ArtemovSA/ILC_project/Info/Docs/Список команд устройства.docx

Список команд устройства (клиента)

Топик | Тип | Описание | Пример
/maser/devices | sub | Получить результат команды | {"devices": ["533906f8-65fd-4168-bad6-390e8c10ace3", "c90d2908-3bd2-11e8-b467-0ed5f89f718b"], "count": 2}
/master/show_devices | pub | Команда показать устройства
/master/new_device | pub | Добавить устройство в писок с уникальным ID | Id устройства
/master/stop_device | pub | Удалить устройство из списка | Id устройства
/variables/# | sub | Просто мониторить приходящие параметры от всех устройств
/variables/devID/# | pub/ sub | Отправить или получить параметры от устройства
/variables/devID/var1 | pub | Отправить или получить параметр var1
/attributes/# | pub/ sub | Отправить или получить атрибуты устройства
/attributes/devID/name | pub | Отправить имя устройства
