ArtemovSA/ILC_project/Info/Прошивка/Прошивка инструкция.docx

Подключение

Необходимо сделать переходник с разъёма j-Link на плату для 3-х проводников (X5 – GND, X3 – SWDIO, X2 – SWDCLK, X1 – RESET)

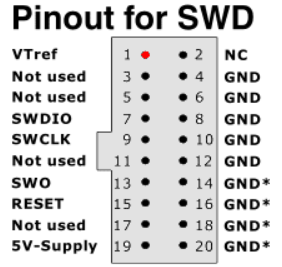
[picture p31: figure]

Рисунок -Разъем на J-LINK

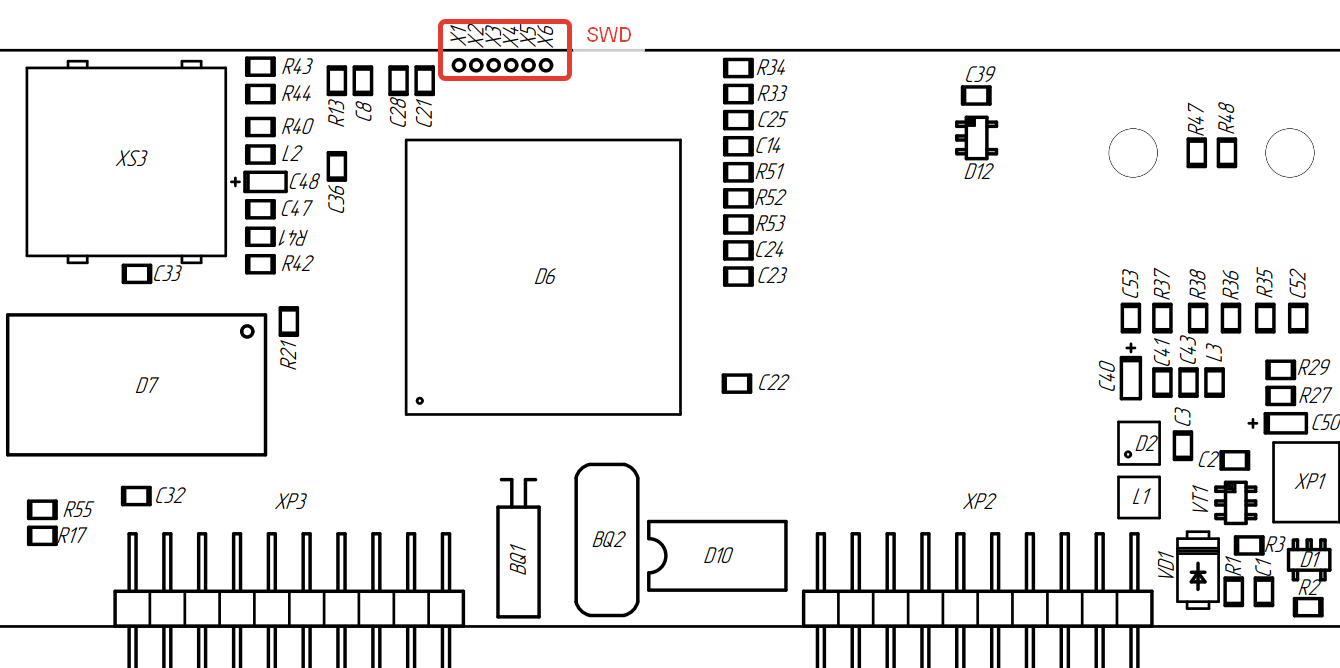
[picture p32: figure]
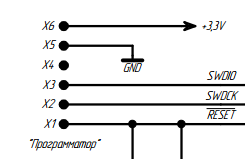
[picture p33: figure]

Рисунок – разъем на плате

Программирование

Открыть программу:

Создать новый проект

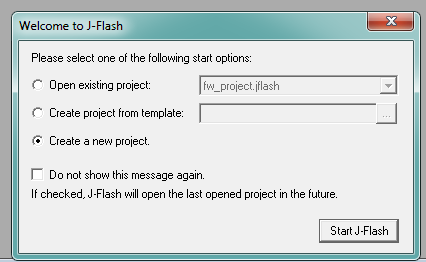
[picture p34: figure]

Options->Project settings (ALT+F7) ->Вкладка Target Interfase

Выбрать SWD

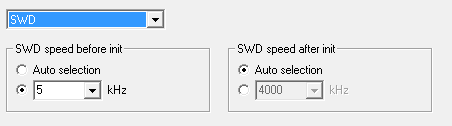
[picture p35: figure]

Вкладка CPU

Выбрать Device

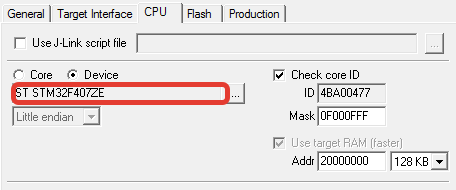
[picture p36: figure]

Из списка:

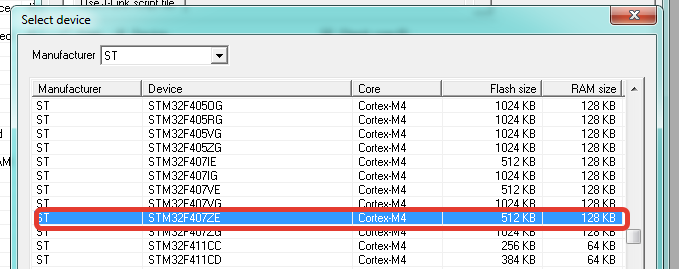
[picture p37: figure]

File->Open data file

Сначала открыть Bootloader.bin

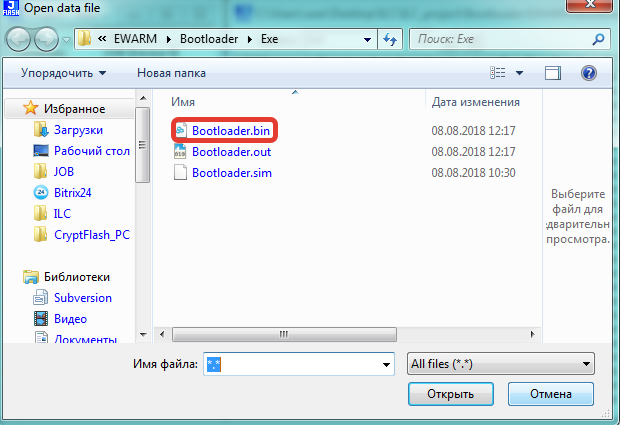
[picture p38: figure]

Указать начальный адрес в 0

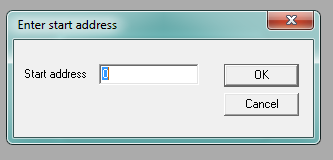
[picture p39: figure]
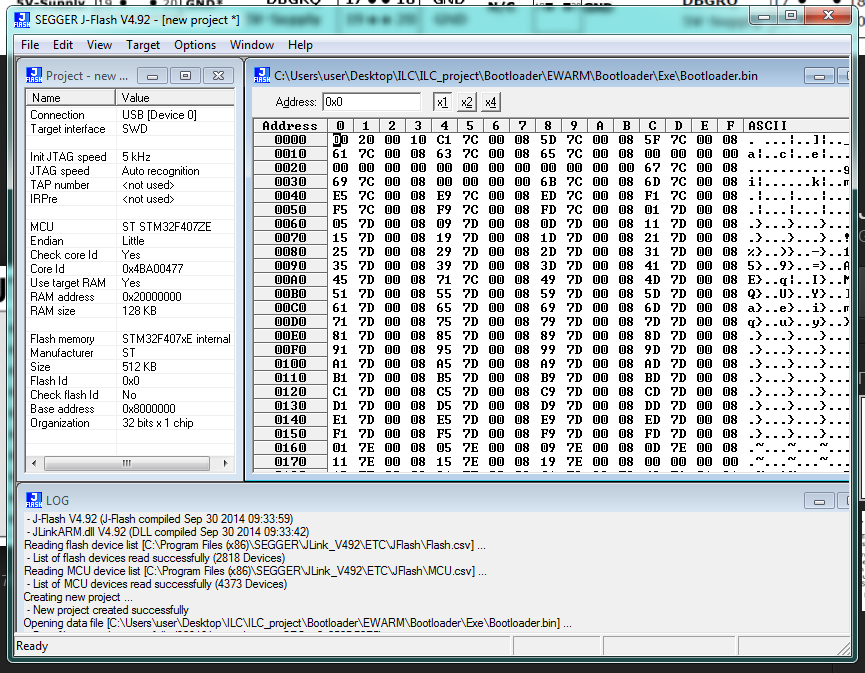
[picture p40: figure]

Убедиться в подаче питания и подключении платы.

Нажать Program & Verify (F6)

После прошивки бутлоадера. Открыть ILC.bin (основную программу)

Указать стартовый адрес со смещением 8000

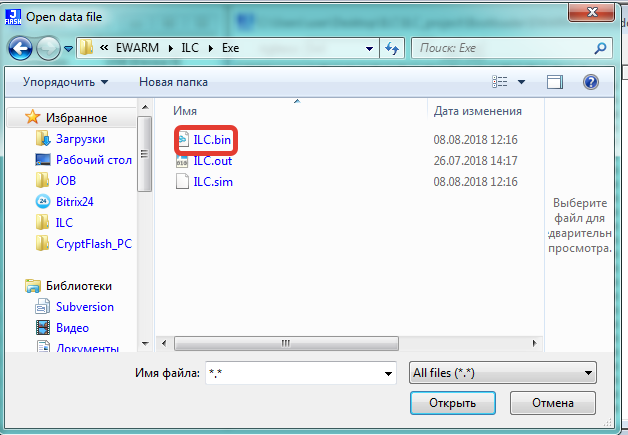
[picture p41: figure]
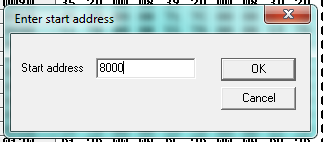
[picture p42: figure]

Нажать Program & Verify (F6)

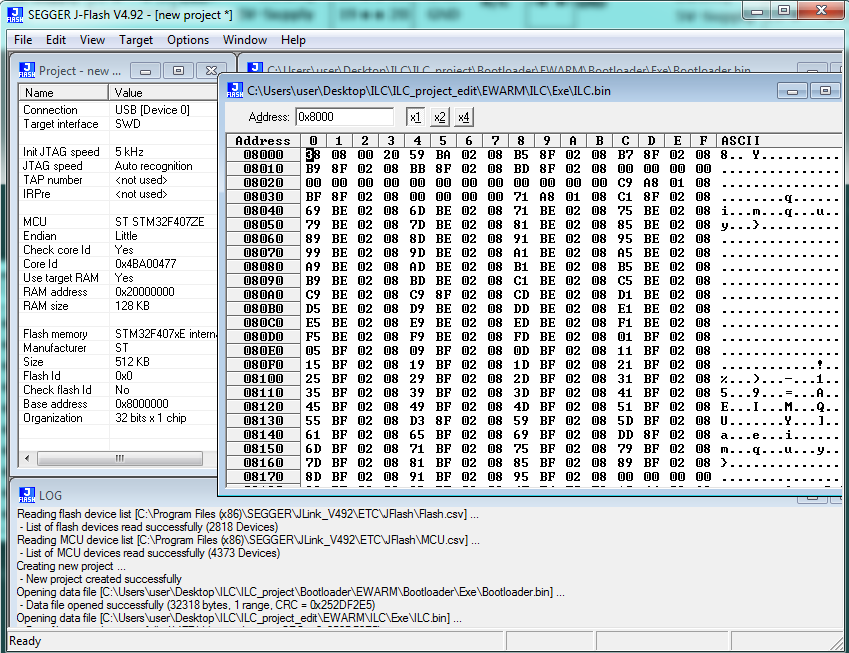
[picture p43: figure]
