ArtemovSA/ILC_project/Info/Второй подряд/структура.docx

1 Макет отладки силовой части счетчика

1.1 Макет потребителя (V9203 схема подключения потребителя с защитой)

1.2 Изменение режимов работы сети, их эмуляция

2 Отладочные средства контроллера (принципы отладки, интерфейс отладки)

2.1 Вывод отладочной информации (Логи, printf, swo)

2.2 Дополнительные отладочные средства

3 Отладочные средства интерфейса RS485/Modbus RTU

4. Отладка интерфейсов взаимодействия периферии
