ArtemovSA/ILC_project/Info/Схемы/GSM/IOT_GSM3G_v0_СБ_bot.pdf

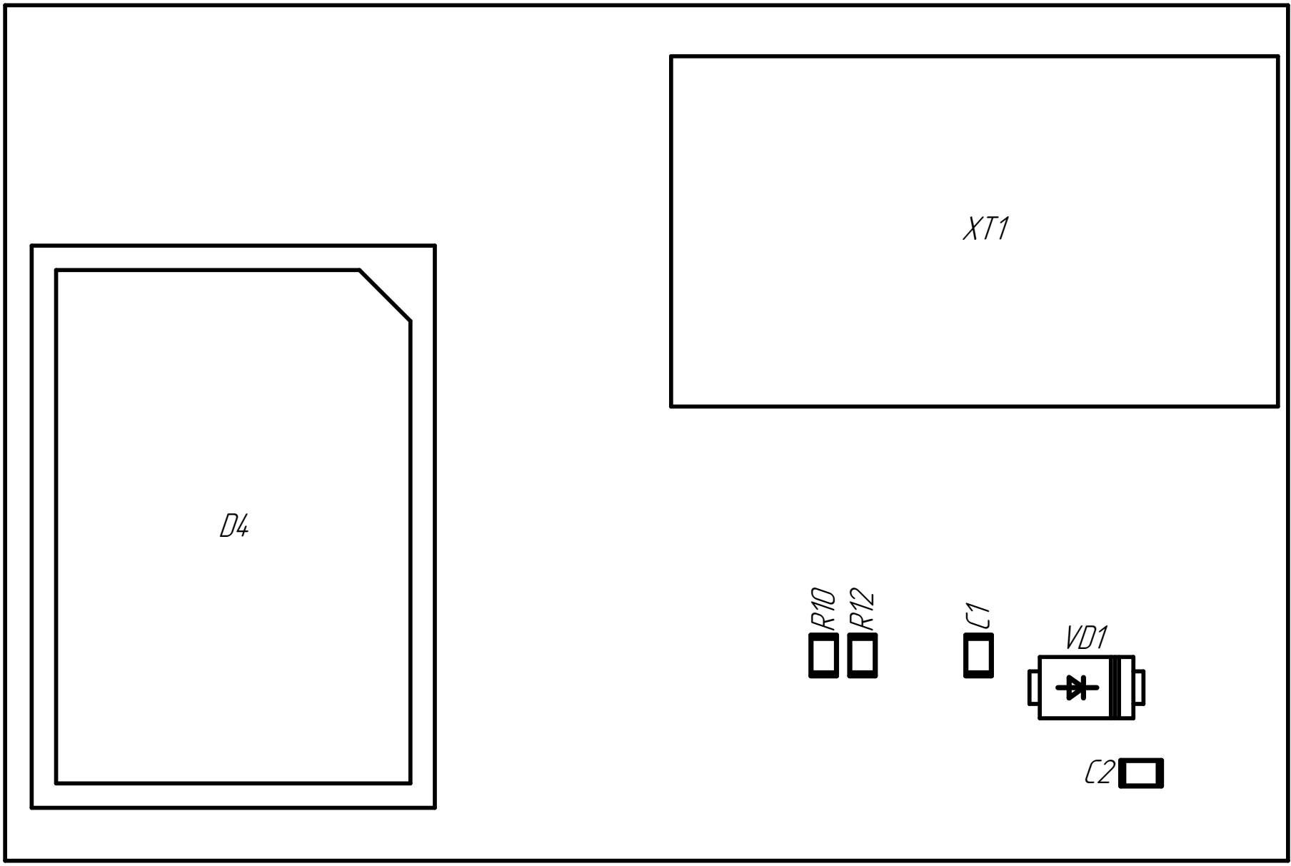
[picture p72: figure]
