ArtemovSA/ILC_project/Info/Второй подряд/Отчет 2.2/Без имени-1.png

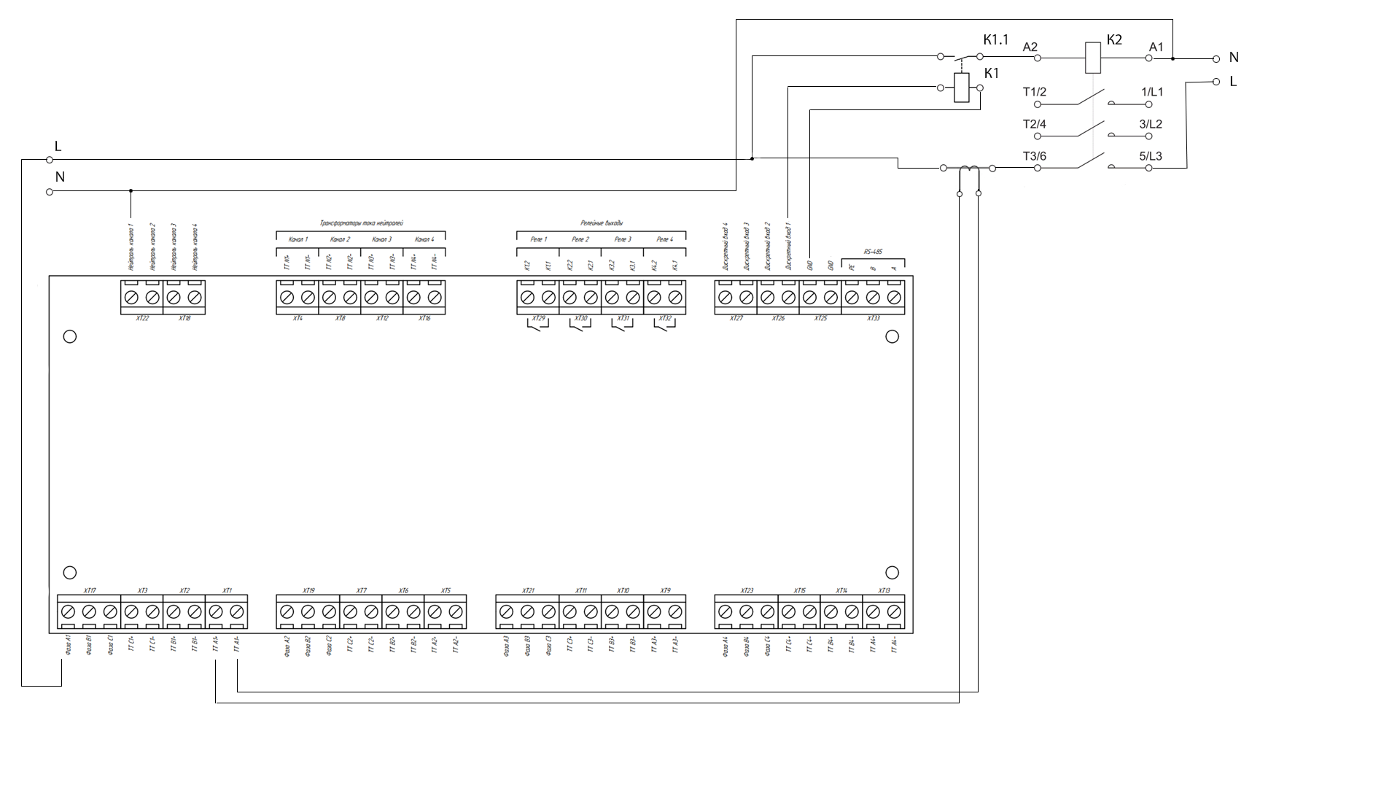
Info/Второй подряд/Отчет 2.2/Без имени-1.png
