ArtemovSA/ILC_project/Info/Отчет_3/Speed test.xlsx

T=1
 | Длина собщения
 | 8 | 16 | 32 | 64 | 128 | 256 | 512 | 1024 | 2048 | 4096 | 8192 | 16384 | 32768
Потери | 0.20% | 0.20% | 0.20% | 0.30% | 0.40% | 0.30% | 0.10% | 0.20% | 0.60% | 0.40% | 0.70% | 0.60% | 1.40%
Среднее время | 1 | 1 | 1 | 1 | 1 | 1 | 1 | 1 | 1 | 1 | 2 | 3 | 6
max время | 3 | 2 | 2 | 2 | 2 | 2 | 2 | 2 | 3 | 3 | 3 | 5 | 7
min время | 1 | 1 | 1 | 1 | 1 | 1 | 1 | 1 | 1 | 1 | 1 | 3 | 5
T=5
 | Длина собщения
 | 8 | 16 | 32 | 64 | 128 | 256 | 512 | 1024 | 2048 | 4096 | 8192 | 16384 | 32768
Потери | 0.10% | 0.10% | 0.10% | 0.10% | 0.20% | 0.30% | 0.30% | 0.30% | 0.20% | 0.20% | 0.60% | 0.50% | 1.20%
Среднее время | 1 | 1 | 1 | 1 | 1 | 1 | 1 | 1 | 1 | 2 | 2 | 3 | 6
max время | 1 | 1 | 1 | 1 | 2 | 2 | 2 | 2 | 2 | 3 | 3 | 5 | 9
min время | 1 | 1 | 1 | 1 | 1 | 1 | 1 | 1 | 1 | 1 | 1 | 3 | 5
T=10
 | Длина собщения
 | 8 | 16 | 32 | 64 | 128 | 256 | 512 | 1024 | 2048 | 4096 | 8192 | 16384 | 32768
Потери | 0.20% | 0.40% | 0.10% | 0.20% | 0.10% | 0.30% | 0.20% | 0.20% | 0.40% | 0.40% | 0.60% | 0.60% | 1.50%
Среднее время | 1 | 1 | 1 | 1 | 1 | 1 | 1 | 1 | 1 | 1 | 2 | 3 | 6
max время | 1 | 1 | 2 | 2 | 2 | 1 | 2 | 2 | 2 | 2 | 3 | 5 | 7
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
