ArtemovSA/ILC_project/Info/Схемы/CPU/IOT_CPU_v0_Э3_л3.pdf

# SDIO_D0 SDIO_D2 RD- TD+

## Ê ïëàòå ââîäà-âûâîäà

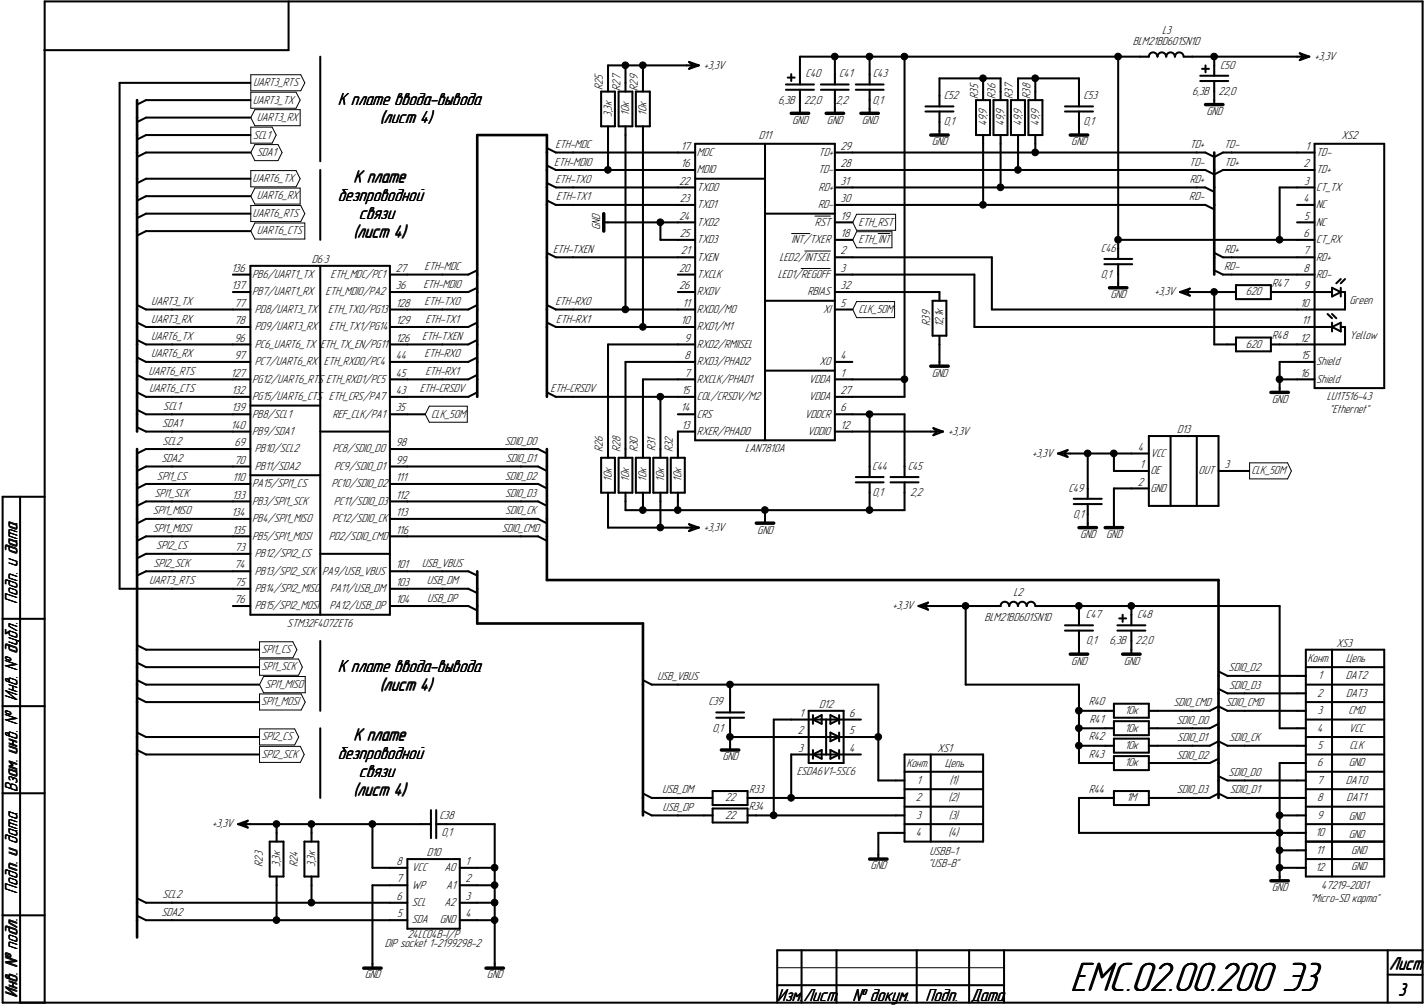
[picture p75: page 1]

27 ETH_MDC/PC1

3 LED1/REGOFF

Âçàì. èíâ. ¹ Èíâ. ¹ äóáë. Ïîäï. è äàòà

Êîíò. | Öåïü
1 | DAT2

Èíâ. ¹ ïîäë. Ïîäï. è äàòà Èçì.Ëèñò Èçì.Ëèñò ¹ äîêóì. Äàòà Ëèñò3

11 | GND
12 | GND

ÅÌÑ.02.00.200 Ý3

Ïîäï.
