ArtemovSA/ILC_project/Info/Схемы/CPU/IOT_CPU_v0_Э3_л4.pdf

## Ê ïëàòå ââîäà-âûâîäà

## Ê ïëàòå áåñïðîâîäíîé ñâÿçè

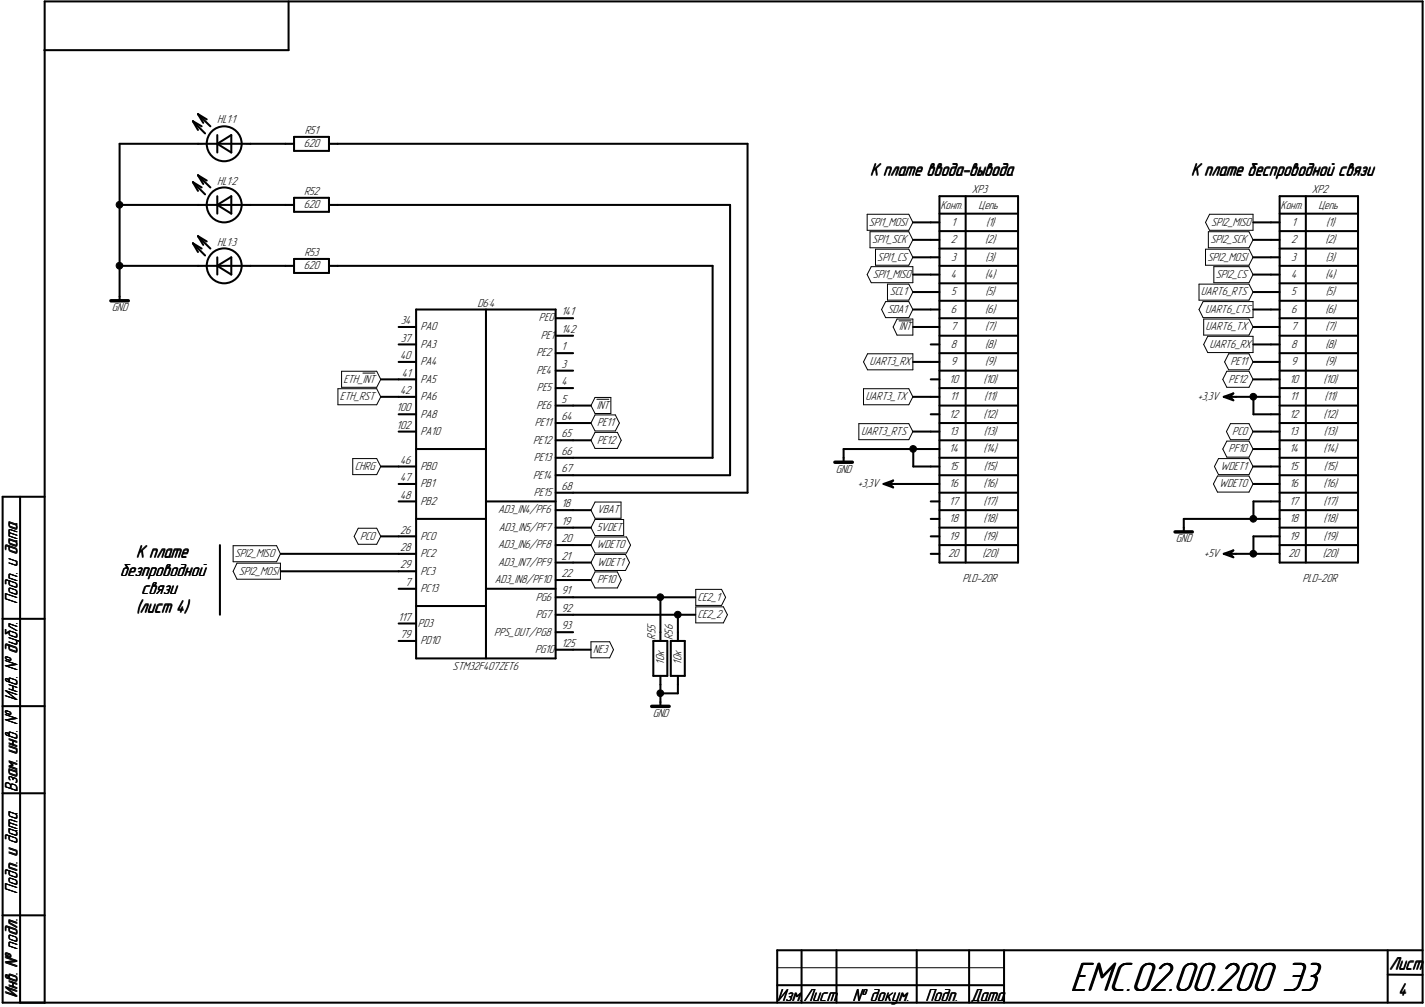
[picture p76: page 1]
GND; WDET1; 5VDET; VBAT; WDET0; INT; ETH_RST; UART3_TX; SCL1; SPI1_SCK; UART6_RX; UART6_RTS; SPI2_SCK; SPI2_MISO; SPI2_MOSI; CHRG; ETH_INT; UART3_RTS; SDA1; UART3_RX; SPI1_MOSI; SPI1_CS; SPI1_MISO; UART6_CTS; UART6_TX; SPI2_CS; Ê ïëàòå áåçïðîâîäíîé ñâÿçè; (ëèñò 4); 93 PPS_OUT/PG8; STM32F407ZET6; Êîíò.; Öåïü; PLD-20R

Âçàì. èíâ. ¹ Èíâ. ¹ äóáë. Ïîäï. è äàòà

Èíâ. ¹ ïîäë. Ïîäï. è äàòà Èçì.Ëèñò Èçì.Ëèñò ¹ äîêóì. Äàòà Ëèñò4

ÅÌÑ.02.00.200 Ý3

Ïîäï.
