ArtemovSA/ILC_project/Info/Схемы/CPU/IOT_CPU_v0_СБ_bot.pdf

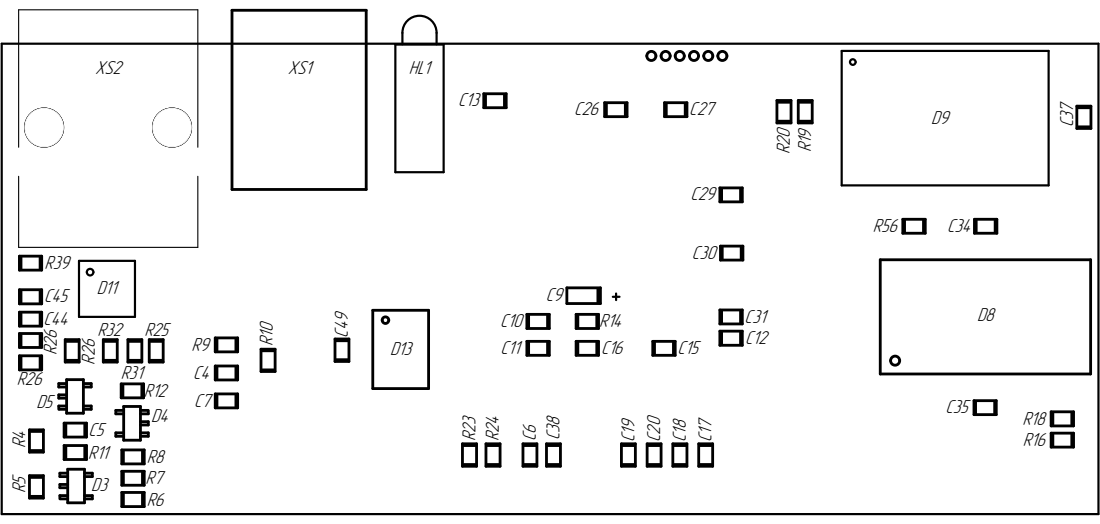
[picture p77: page 1]
