ArtemovSA/ILC_project/Info/Схемы/CPU/IOT_CPU_v0_СБ_top.pdf

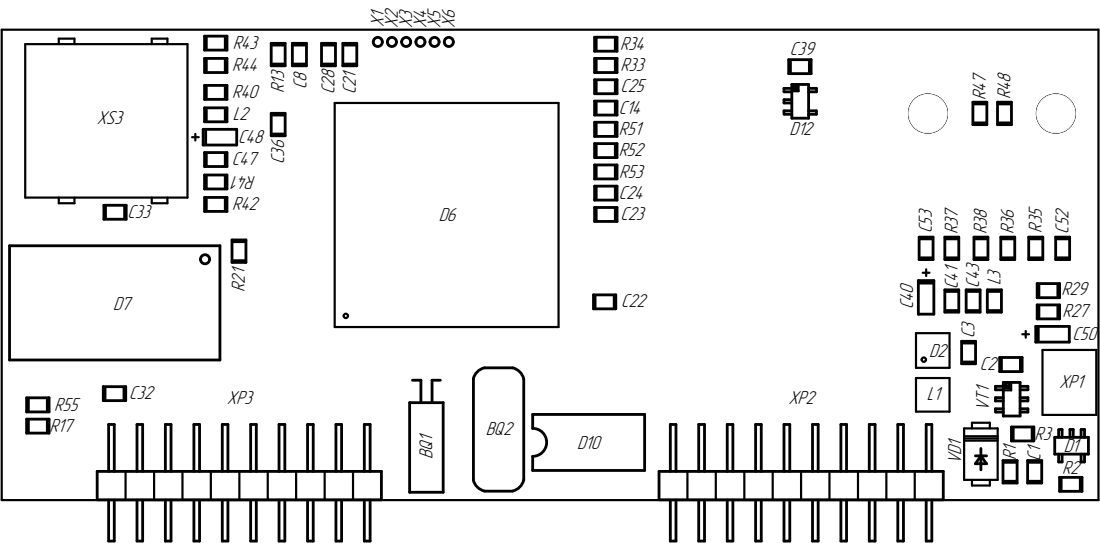
[picture p78: page 1]
