ArtemovSA/ILC_project/Info/Схемы/CPU/IOT_CPU_v0_Э3_л1.pdf

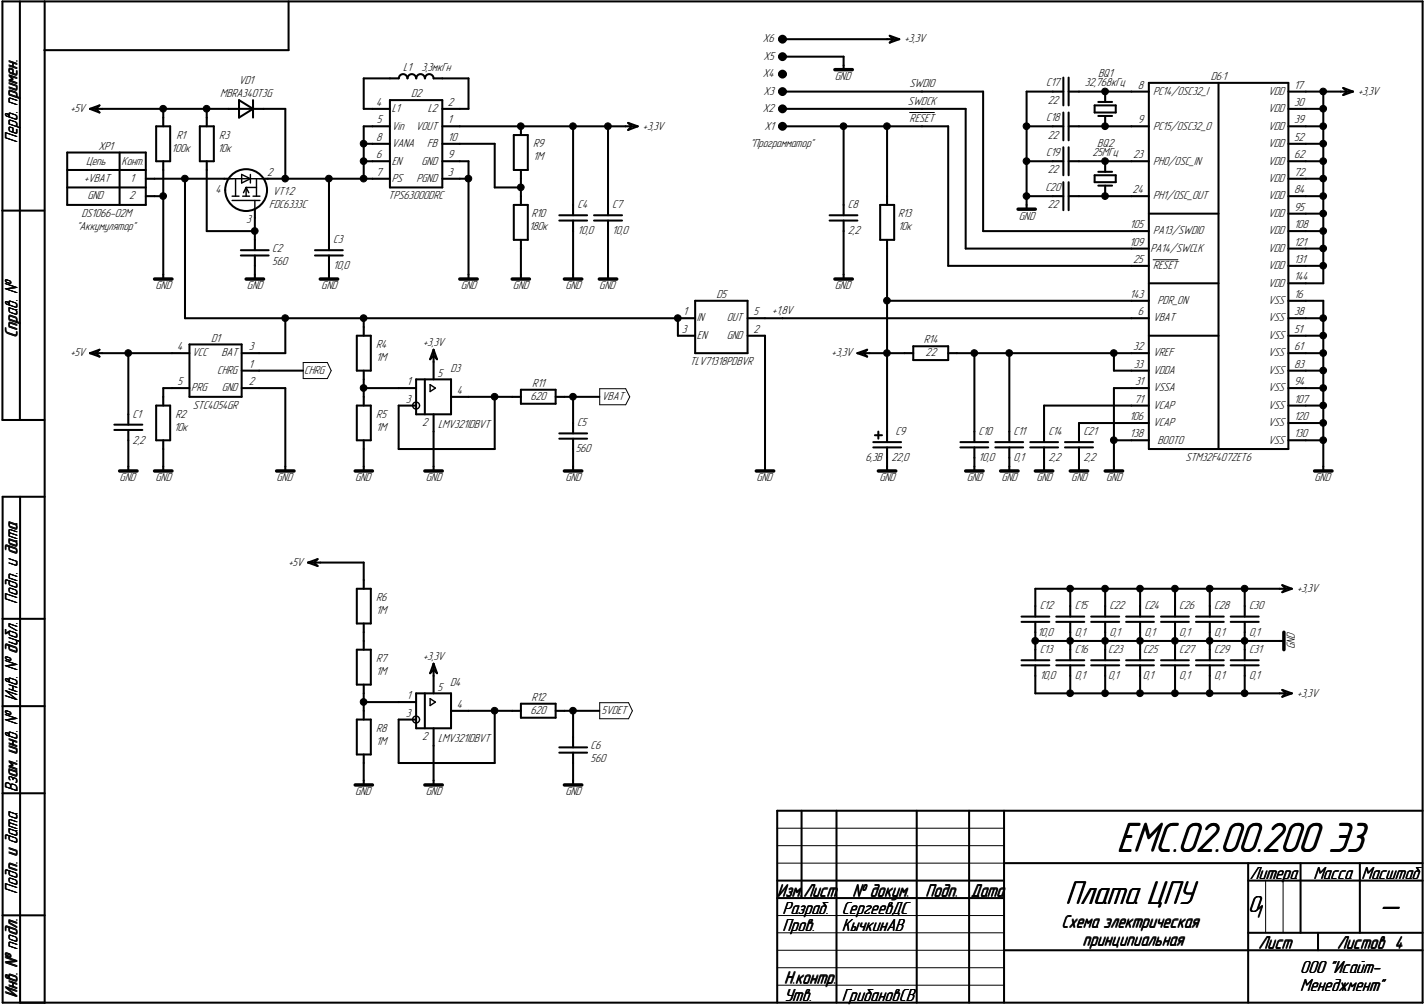
[picture p79: page 1]

Èíâ. ¹ ïîäë. Ïîäï. è äàòà Ñïðàâ. ¹ Ïåðâ. ïðèìåí. Óòâ. ÃðèáàíîâÑÂ Óòâ. ÃðèáàíîâÑÂ 4

Öåïü | Êîíò.
+VBAT | 1
GND | 2

Âçàì. èíâ. ¹ Èíâ. ¹ äóáë.

ÅÌÑ.02.00.200 Ý3

Èçì.Ëèñò Èçì.Ëèñò ¹ äîêóì. | | | Ïîäï. | Äàòà | | Î 1 | | | _
Ðàçðàá. | | ÑåðãååâÄÑ
Ïðîâ. | | Êû÷êèíÀÂ

Ïëàòà ÖÏÓ Ñõåìà ýëåêòðè÷åñêàÿ ïðèíöèïèàëüíàÿ | Ëèòåðà | Ìàññà | Ìàñøòàá Ì Ëèòåðà

Ëèñò | Ëèñòîâ

ÎÎÎ"Èñàéò-Ìåíåäæìåíò"
