ArtemovSA/ILC_project/Info/Схемы/CPU/IOT_CPU_v0_Э3_л2.pdf

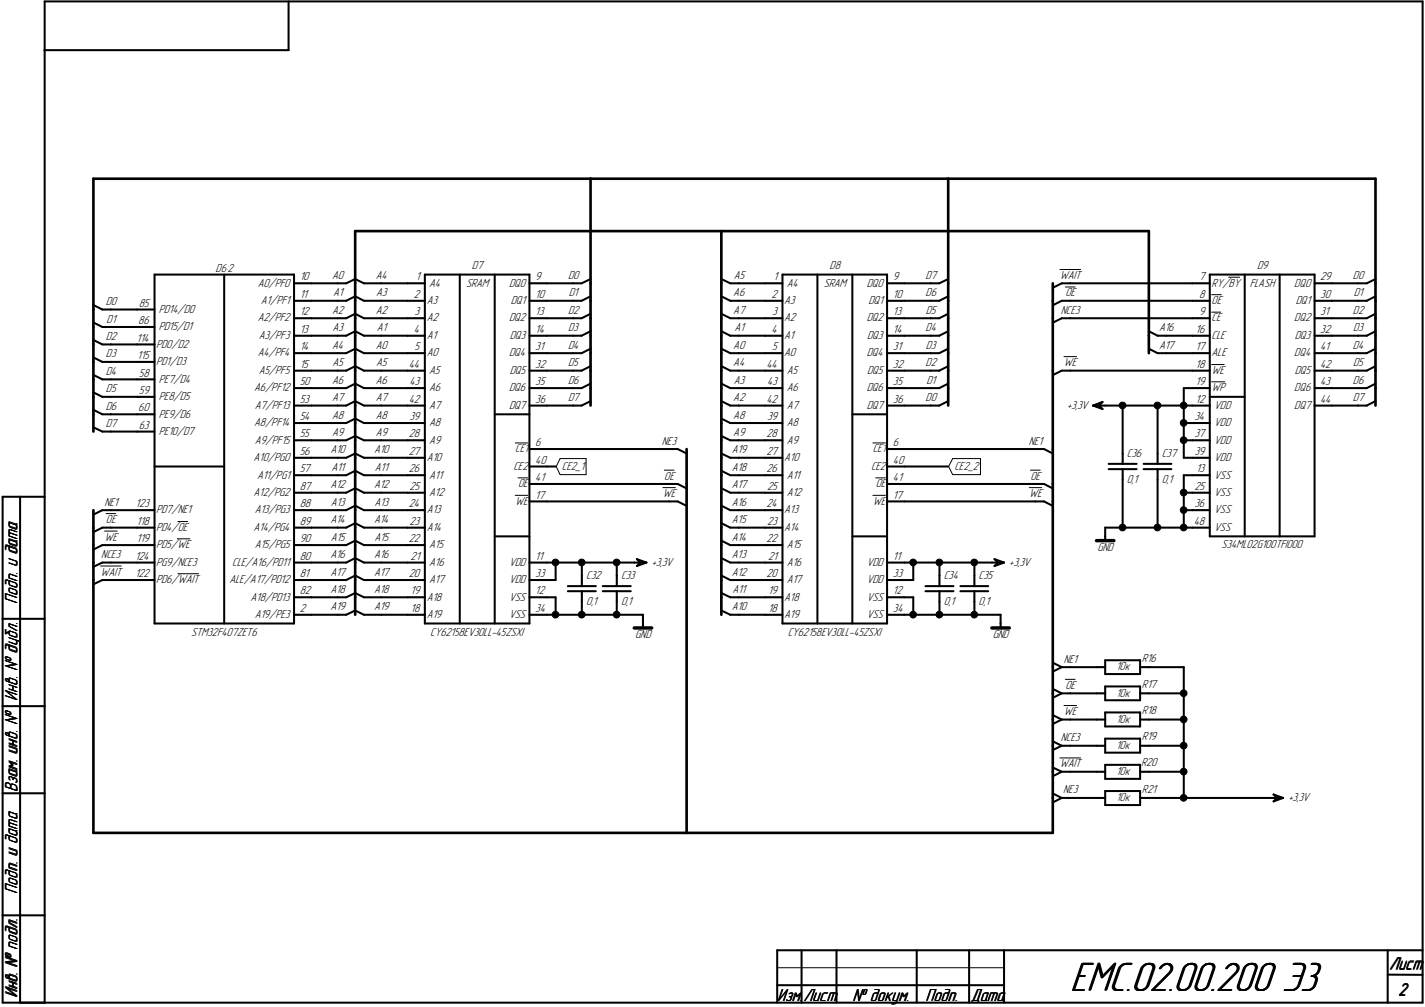
[picture p80: page 1]

Âçàì. èíâ. ¹ Èíâ. ¹ äóáë. Ïîäï. è äàòà

Èíâ. ¹ ïîäë. Ïîäï. è äàòà Èçì.Ëèñò Èçì.Ëèñò ¹ äîêóì. Äàòà Ëèñò2

ÅÌÑ.02.00.200 Ý3

Ïîäï.
