ArtemovSA/ILC_project/Info/Схемы/GSM/IOT_GSM3G_v0_СБ_top.pdf

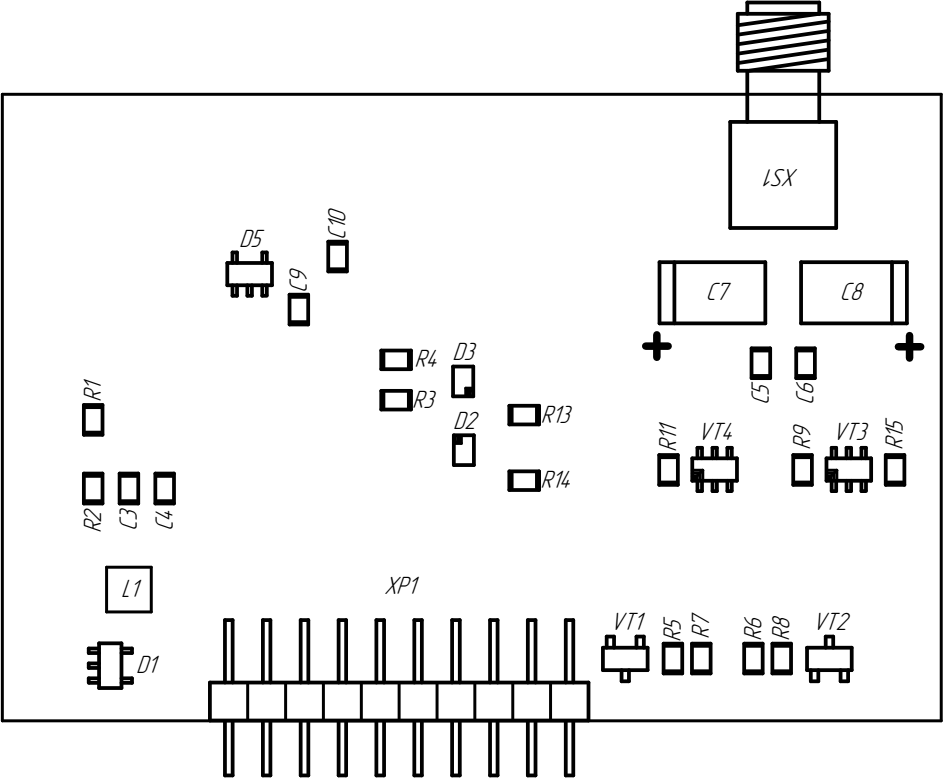
[picture p81: page 1]
