ArtemovSA/ILC_project/Info/Схемы/GSM/IOT_GSM3G_v0_схема.pdf

## Ê ïëàòå ÖÏÓ

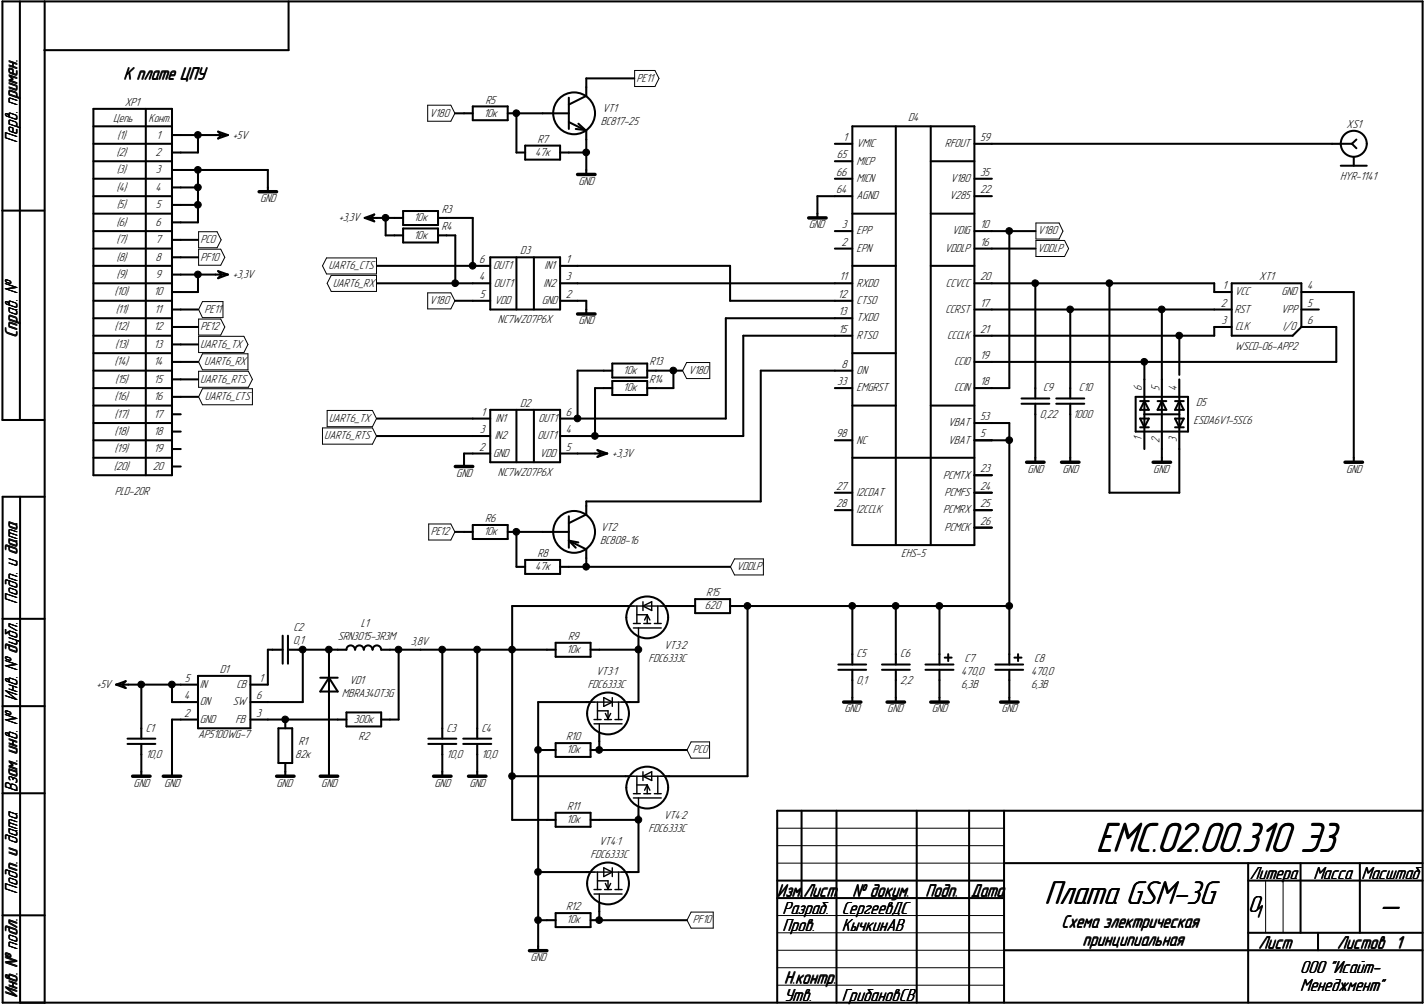
[picture p82: page 1]

Èíâ. ¹ ïîäë. Ïîäï. è äàòà Ñïðàâ. ¹ Ïåðâ. ïðèìåí. Óòâ. ÃðèáàíîâÑÂ Óòâ. ÃðèáàíîâÑÂ 1

Âçàì. èíâ. ¹ Èíâ. ¹ äóáë.

ÅÌÑ.02.00.310 Ý3

Èçì.Ëèñò Èçì.Ëèñò ¹ äîêóì. | | | Ïîäï. | Äàòà | | Î 1 | | | _
Ðàçðàá. | | ÑåðãååâÄÑ
Ïðîâ. | | Êû÷êèíÀÂ

Ïëàòà GSM-3G Ñõåìà ýëåêòðè÷åñêàÿ ïðèíöèïèàëüíàÿ | Ëèòåðà | Ìàññà | Ìàñøòàá Ì Ëèòåðà

Ëèñò | Ëèñòîâ

ÎÎÎ"Èñàéò-Ìåíåäæìåíò"
