ArtemovSA/ILC_project/Info/Схемы/IO/IOT_IO_v0_СБ_bot.pdf

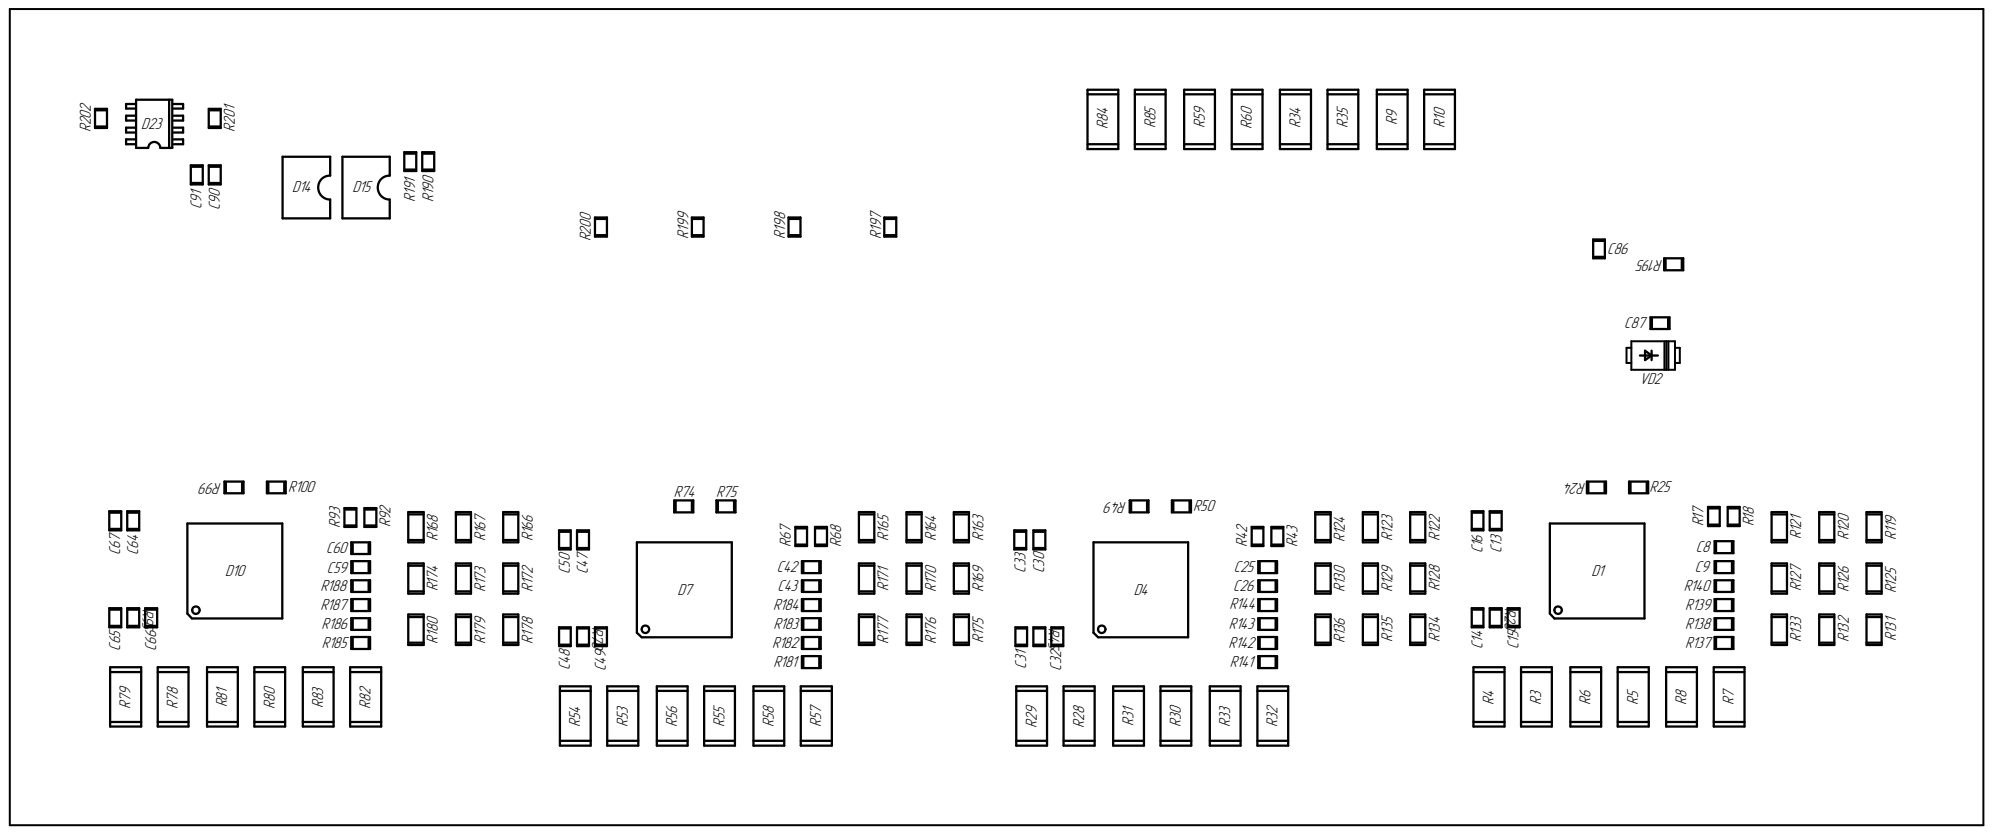
[picture p83: page 1]
