ArtemovSA/ILC_project/Info/Схемы/IO/IOT_IO_v0_СБ_top.pdf

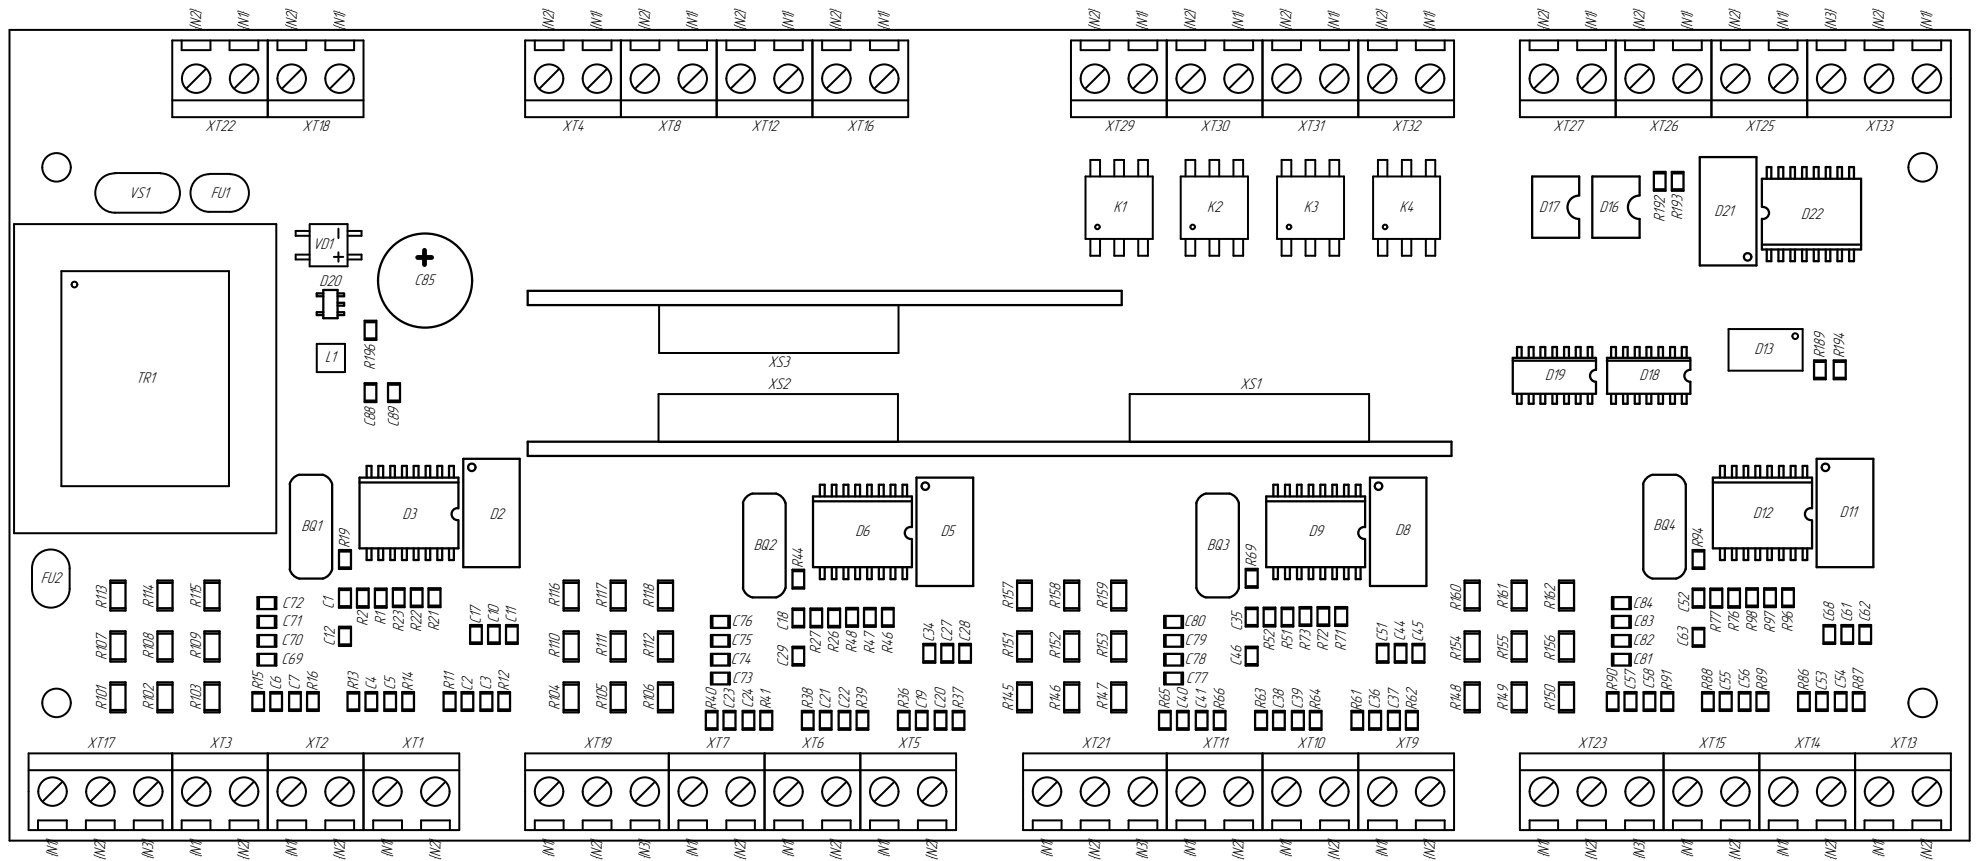
[picture p84: page 1]
