ArtemovSA/ILC_project/Info/Схемы/IO/IOT_IO_v0_Э3_л1.pdf

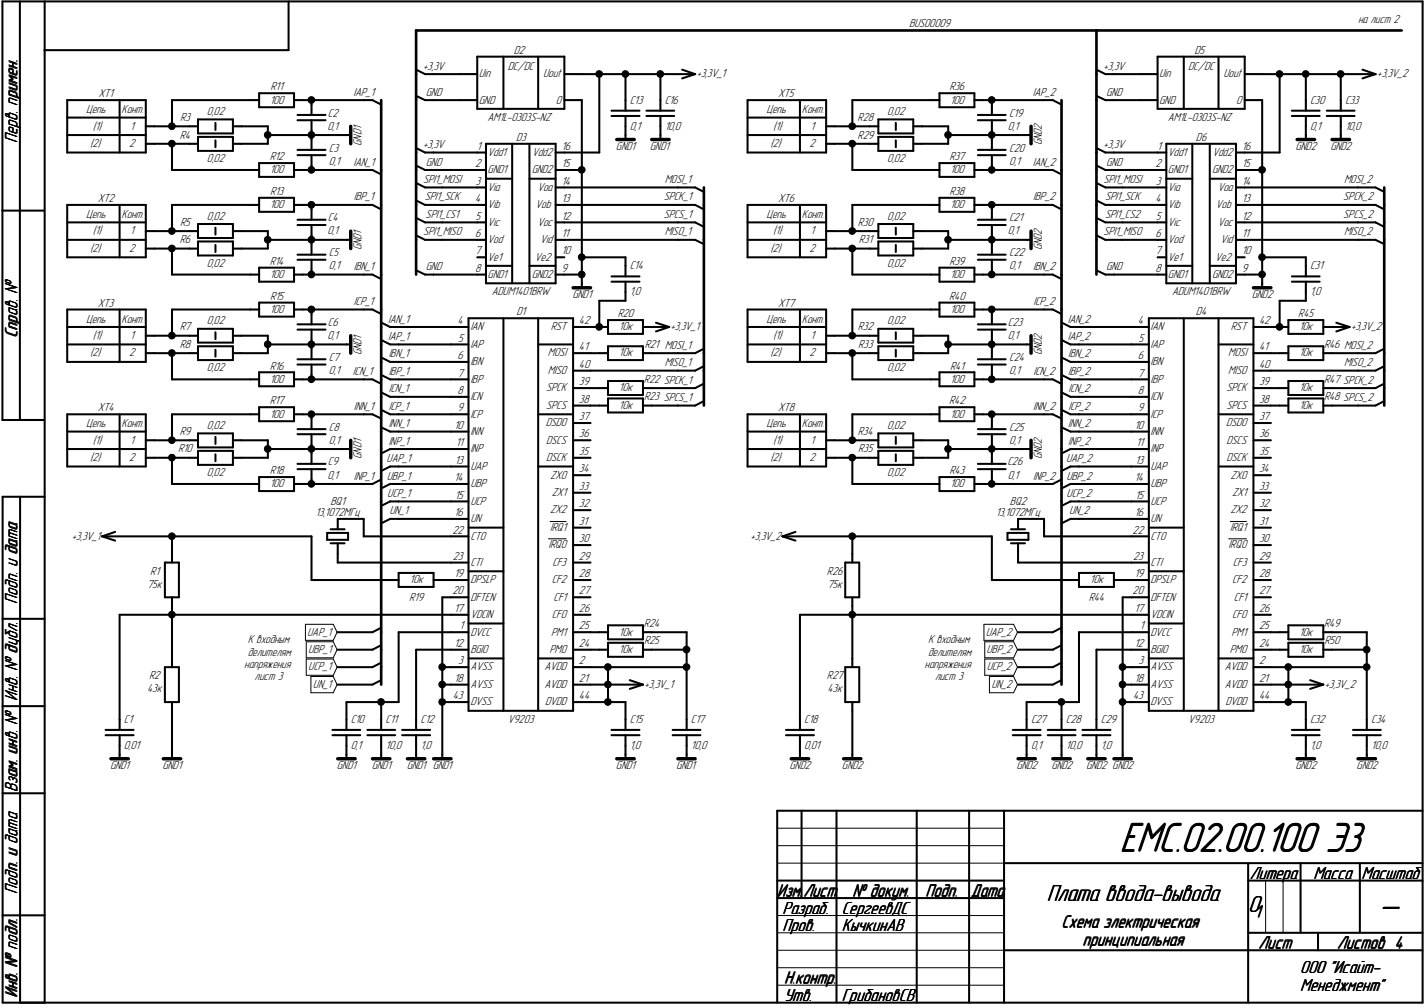
[picture p85: page 1]

Èíâ. ¹ ïîäë. Ïîäï. è äàòà Ñïðàâ. ¹ Ïåðâ. ïðèìåí. Óòâ. ÃðèáàíîâÑÂ Óòâ. ÃðèáàíîâÑÂ 4

Âçàì. èíâ. ¹ Èíâ. ¹ äóáë.

ÅÌÑ.02.00.100 Ý3

Èçì.Ëèñò Èçì.Ëèñò ¹ äîêóì. | | | Ïîäï. | Äàòà | | Î 1 | | | _
Ðàçðàá. | | ÑåðãååâÄÑ
Ïðîâ. | | Êû÷êèíÀÂ

Ïëàòà ââîäà-âûâîäà Ñõåìà ýëåêòðè÷åñêàÿ ïðèíöèïèàëüíàÿ | Ëèòåðà | Ìàññà | Ìàñøòàá Ì Ëèòåðà

Ëèñò | Ëèñòîâ

ÎÎÎ"Èñàéò-Ìåíåäæìåíò"
