ArtemovSA/ILC_project/Info/Схемы/IO/IOT_IO_v0_Э3_л4.pdf

| Ê ïëàòå ÖÏÓ BUS00009

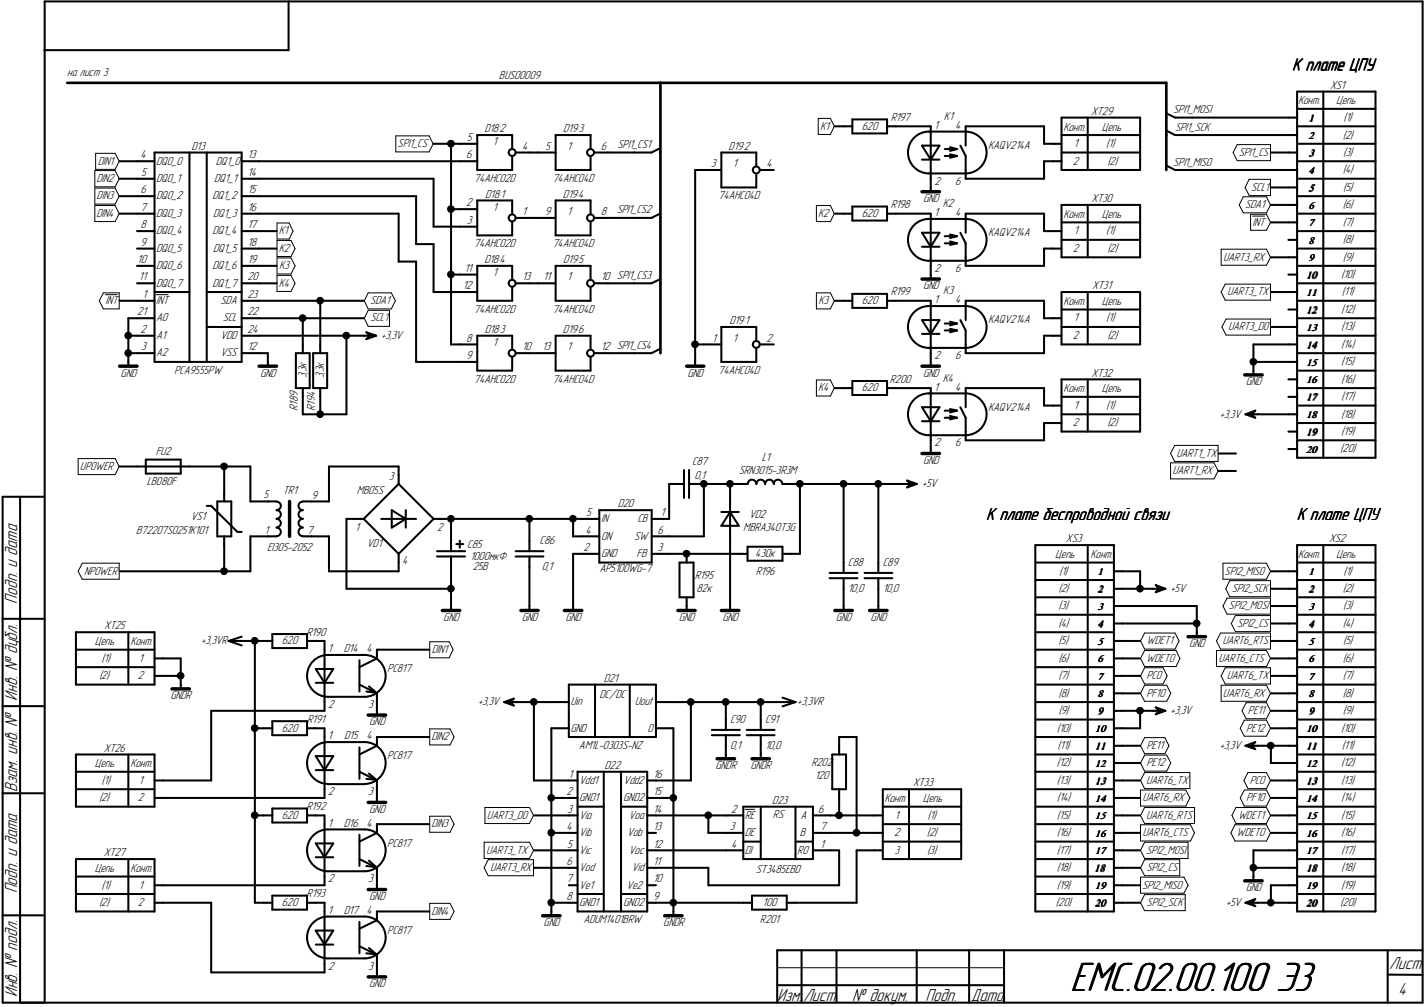
[picture p86: page 1]

Êîíò. | Öåïü

1 | {1}
2 | {2}

Âçàì. èíâ. ¹ Èíâ. ¹ äóáë. Ïîäï. è äàòà

Èíâ. ¹ ïîäë. Ïîäï. è äàòà Èçì.Ëèñò ¹ äîêóì. Äàòà Ëèñò

ÅÌÑ.02.00.100 Ý3

Ïîäï.
