ArtemovSA/ILC_project/Info/Схемы/IO/IOT_IO_v0_Э4.pdf

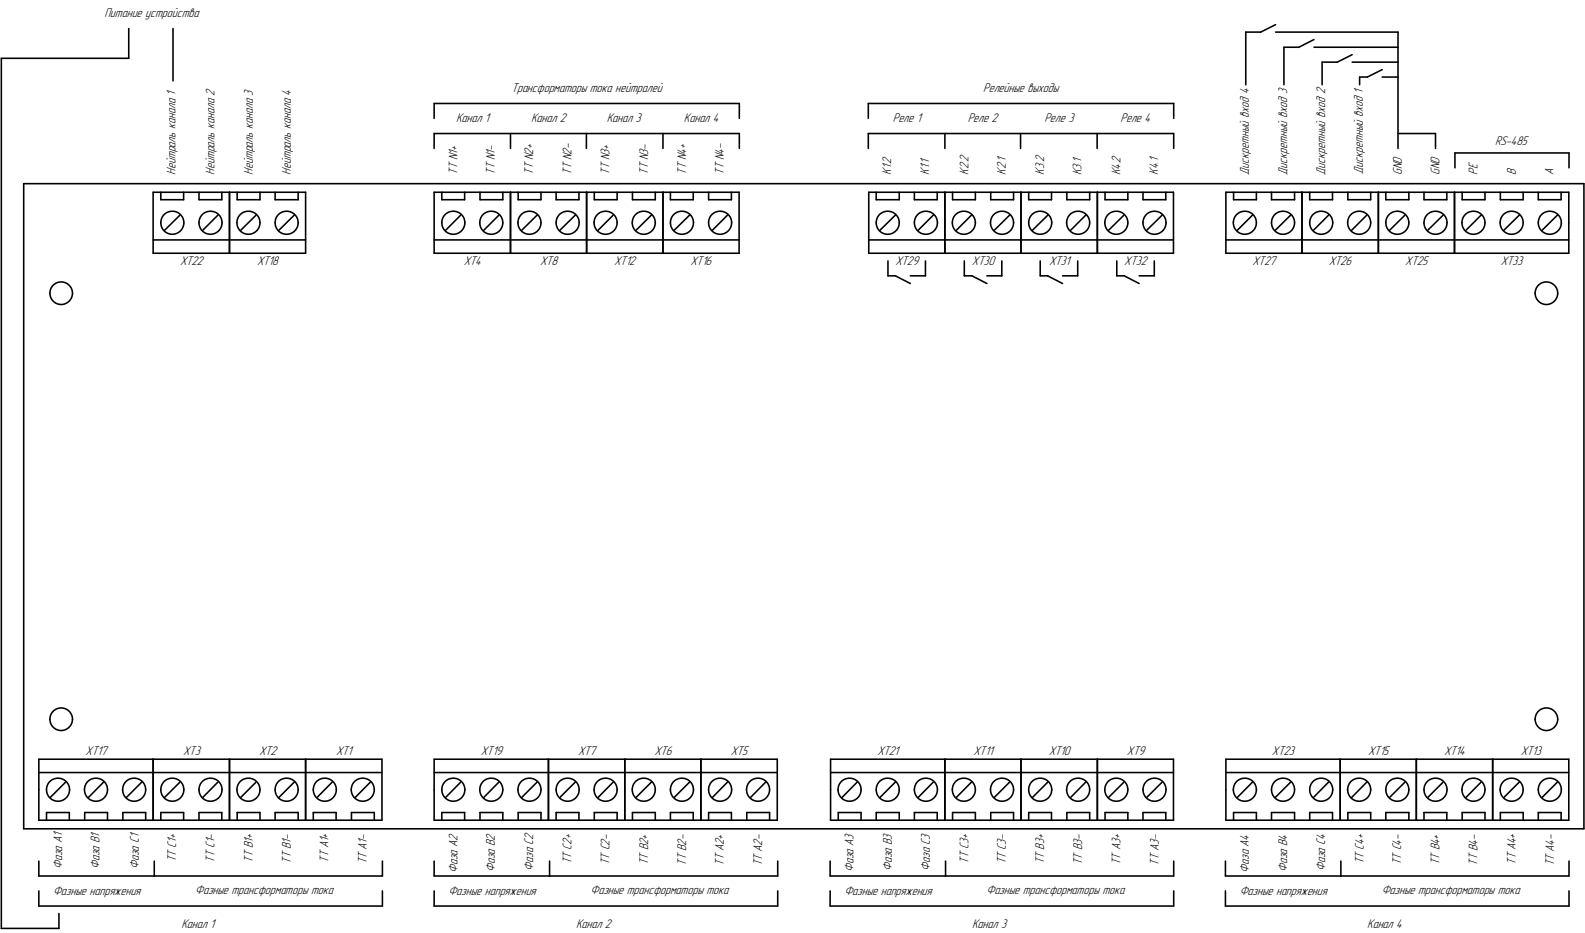
[picture p87: page 1]
Êàíàë 3; Ðåëå 1; Ðåëå 2; Ðåëå 4; Ôàçíûå íàïðÿæåíèÿ; Êàíàë 2; Ðåëå 3; Ðåëåéíûå âûõîäû; Ôàçíûå òðàíñôîðìàòîðû òîêà; Êàíàë 1; Ïèòàíèå óñòðîéñòâà; Êàíàë 4; GND; Ôàçà À1; Ôàçà Â1; Ôàçà Ñ1; Íåéòðàëü êàíàëà 3; Íåéòðàëü êàíàëà 4; Ôàçà À4; Ôàçà Â4; Ôàçà Ñ4; Äèñêðåòíûé âõîä 4; Äèñêðåòíûé âõîä 3; Ôàçà À2; Ôàçà Â2; Ôàçà Ñ2; Ôàçà À3; Ôàçà Â3; Ôàçà Ñ3; Íåéòðàëü êàíàëà 1; Íåéòðàëü êàíàëà 2; Äèñêðåòíûé âõîä 2; Äèñêðåòíûé âõîä 1

Òðàíñôîðìàòîðû òîêà íåéòðàëåé

Ôàçíûå òðàíñôîðìàòîðû òîêà
