ArtemovSA/ILC_project/(list of files, drawings)

Other design files:
Info/Схемы/CPU/Imported IOT_CPU_v0.PrjPcb/First_Sheet.SCHDOC
Info/Схемы/CPU/Imported IOT_CPU_v0.PrjPcb/IOT_CPU_v0.PcbDoc
Info/Схемы/CPU/Imported IOT_CPU_v0.PrjPcb/IOT_CPU_v0.PrjPcb
Info/Схемы/CPU/Imported IOT_CPU_v0.PrjPcb/Sheet1.SCHDOC
Info/Схемы/CPU/Imported IOT_CPU_v0.PrjPcb/Sheet2.SCHDOC
Info/Схемы/CPU/Imported IOT_CPU_v0.PrjPcb/Sheet3.SCHDOC
Info/Схемы/CPU/Imported IOT_CPU_v0.PrjPcb/Sheet4.SCHDOC
Info/Схемы/CPU/IOT_CPU_v0.pcb
Info/Схемы/GSM/IOT_GSM3G_v0.pcb
Info/Схемы/IO/Imported IOT_IO_v0.PrjPcb/First_Sheet.SCHDOC
Info/Схемы/IO/Imported IOT_IO_v0.PrjPcb/IOT_IO_v0.PcbDoc
Info/Схемы/IO/Imported IOT_IO_v0.PrjPcb/IOT_IO_v0.PrjPcb
Info/Схемы/IO/Imported IOT_IO_v0.PrjPcb/Sheet1.SCHDOC
Info/Схемы/IO/Imported IOT_IO_v0.PrjPcb/Sheet2.SCHDOC
Info/Схемы/IO/Imported IOT_IO_v0.PrjPcb/Sheet3.SCHDOC
Info/Схемы/IO/Imported IOT_IO_v0.PrjPcb/Sheet4.SCHDOC
Info/Схемы/IO/IOT_IO_v0.pcb
