ArtemovSA/ILC_project/Info/Схемы/V9203_Devkit-master/V9203_Devkit.kicad_pcb

## KiCad design Info/Схемы/V9203_Devkit-master/V9203_Devkit.kicad_pcb (2018-06-10)

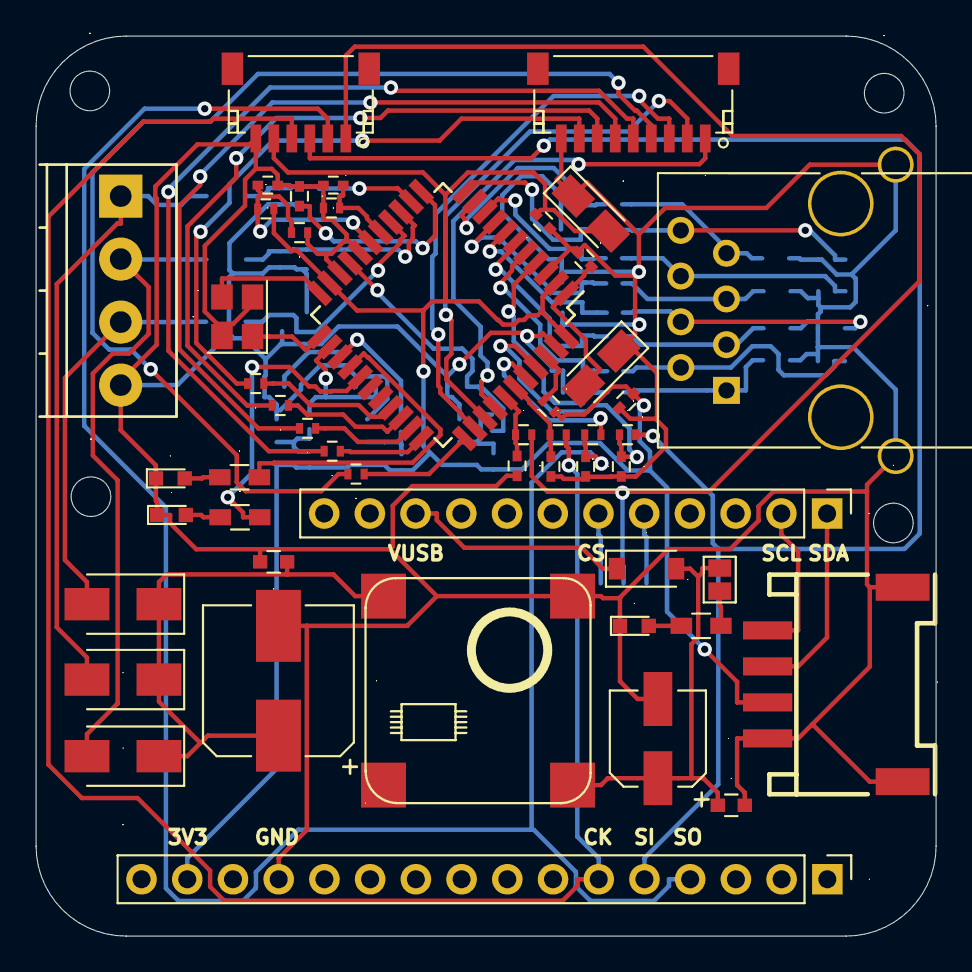
[picture p88: board V9203_Devkit.kicad_pcb from above]

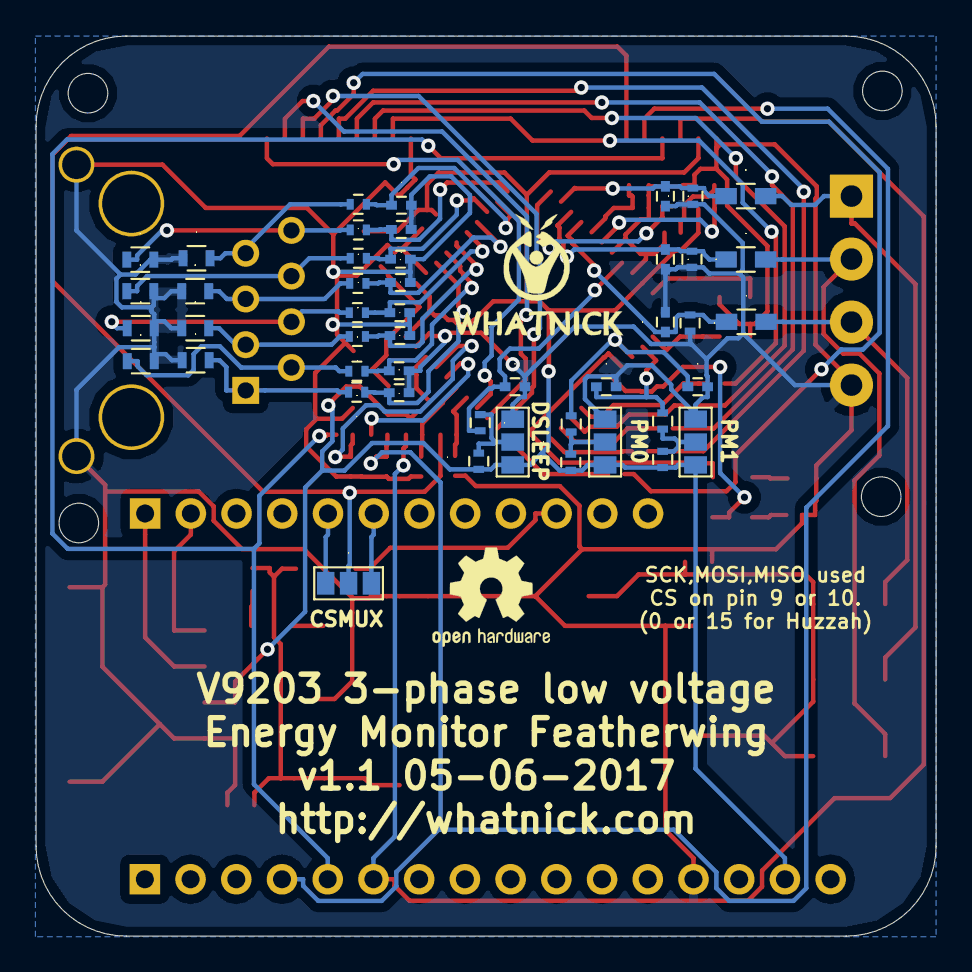
[picture p89: board V9203_Devkit.kicad_pcb from below]

Board: 2 copper layers, 50.0 x 50.0 mm, 102 parts (48 on the bottom side), 71 nets.

Parts:
C1: 220u/50V; CP_Elec_8x10
C2: 100u/16V; CP_Elec_5x5.8
C3: 1u/16V; C_0603
C4: 1u/50V; C_0603
C5, C6, C7, C8, C9, C10, C11, C12, C15, C17, C18, C19, C21, C28, C29, C30: 100n; C_0402
C13, C14: 10u; CP_Tantalum_Case-A_EIA-3216-18_Reflow
C16, C20, C27: 1u; C_0402
C22: 10n; C_0402
C23, C24, C25, C26: 1n; C_0402
D1, D2, D3: D_Schottky; D_SMA_Standard
D4, D6, D7: LED; LED_0603
D5: D_Schottky; D_SOD-123
J1: RJ45; RJ45_8
J2: CONN_01X16; Socket_Strip_Straight_1x16_Pitch2.54mm
J3: CONN_01X12; Socket_Strip_Straight_1x12_Pitch2.54mm
J4: Screw_Terminal_1x04; TerminalBlock_Pheonix_PT-3.5mm_4pol
J5: GROVE-CONNECTOR-SMD-90D(4+2P-2.0); HW4-SMD-2.0-90D
J6: JST9; JST_SH_SM09B-SRSS-TB_09x1.00mm_Angled
J7, J8, J10, J11: GS3
J9: JST6; JST_SH_SM06B-SRSS-TB_06x1.00mm_Angled
JP1: Jumper_NC_Small; GS2
LOGO1: OPEN_HARDWARE_1; OSHW-Logo2_7.3x6mm_SilkScreen
LOGO2: LOGO; Whatnick_logo
MK1, MK2, MK3, MK4: Mounting_Hole; MountingHole_2.2mm_M2
R1, R27, R28: 1K; R_0603_HandSoldering
R2, R3, R4, R5, R6, R7, R8, R9, R13, R14, R15, R16: 100R; R_0402
R10, R11, R12: 100K; R_0603_HandSoldering
R17, R18, R19, R20, R21, R22, R23, R24: 2.4R/10ppm; R_0603
R25: 75K; R_0402
R26: 43K; R_0402
R29, R30, R31, R32: 1K; R_0402
R33: 10K; R_0402
R34, R35, R36, R37, R38, R39, R40, R41: 20K; R_0402
R42, R43, R44: 100K; R_0402
U1: V9203; TQFP-44_10x10mm_Pitch0.8mm
U2: ROF-78E; SMD-4
Y1: Crystal_GND24; Crystal_SMD_Abracon_ABM8G-4pin_3.2x2.5mm

Connections:
+3V3: C13.2, C16.1, C27.2, J2.15, J5.3, J7.1, J8.1, J9.5, J10.1, R25.2, R33.2, R42.1, R43.1, R44.1, U1.2, U1.21, U1.44
/V9203/DS: C30.1, R41.2, U1.19
/V9203/IAN: C5.1, R2.1, U1.4
/V9203/IAN_IN: J1.1, R2.2, R17.2
/V9203/IAP: C6.2, R3.1, U1.5
/V9203/IAP_IN: J1.2, R3.2, R18.1
/V9203/IBN: C9.1, R6.1, U1.6
/V9203/IBN_IN: J1.3, R6.2, R21.2
/V9203/IBP: C10.2, R7.1, U1.7
/V9203/IBP_IN: J1.4, R7.2, R22.1
/V9203/ICN: C7.1, R4.1, U1.8
/V9203/ICN_IN: J1.5, R4.2, R19.2
/V9203/ICP: C8.2, R5.1, U1.9
/V9203/ICP_IN: J1.6, R5.2, R20.1
/V9203/INN: C11.1, R8.1, U1.10
/V9203/INN_IN: J1.7, R8.2, R23.2
/V9203/INP: C12.2, R9.1, U1.11
/V9203/INP_IN: J1.8, R9.2, R24.1
/V9203/UAP: C17.1, R10.1, R13.2, U1.13
/V9203/UBP: C18.1, R11.1, R14.1, U1.14
/V9203/UCP: C19.1, R12.1, R15.1, U1.15
/V9203/V_CLK: C25.1, R32.1, U1.39
/V9203/V_CS: C24.1, R31.1, U1.38
/V9203/V_MISO: R30.1, U1.40
/V9203/V_MOSI: C26.1, R29.1, U1.41
CS: J9.1, J11.2, R31.2
GND: C1.2, C2.2, C3.2, C4.2, C5.2, C6.1, C7.2, C8.1, C9.2, C10.1, C11.2, C12.1, C13.1, C14.1, C15.1, C16.2, C17.2, C18.2, C19.2, C20.1, C21.2, C22.1, C23.2, C24.2, C25.2, C26.2, C27.1, C28.2, C29.2, C30.2, D4.1, D6.1, D7.1, J1.9, J2.13, J4.4, J5.4, J5.SS1, J5.SS2, J6.9, J7.3, J8.3, J9.6, J10.3, R13.1, R14.2, R15.2, R16.2, R17.1, R18.2, R19.1, R20.2, R21.1, R22.2, R23.1, R24.2, R26.1, U1.3, U1.18, U1.20, U1.43, U2.2, Y1.2, Y1.4
MISO: C23.1, J2.4, J9.2, R30.2
MOSI: J2.5, J9.3, R29.2
unnamed: C1.1, C4.1, D1.1, D2.1, D3.1, U2.1
unnamed: C2.1, C3.1, D5.2, JP1.2, U2.3
unnamed: C14.2, C15.2, U1.1
unnamed: C20.2, U1.12
unnamed: C21.1, R16.1, U1.16
unnamed: C22.2, R25.1, R26.2, U1.17
unnamed: D4.2, R1.2
unnamed: D6.2, R27.1
unnamed: D7.2, R28.1
unnamed: J6.1, U1.37
unnamed: J6.2, U1.36
unnamed: J6.3, U1.35
unnamed: J6.4, R34.2
unnamed: J6.5, R37.2
unnamed: J6.6, R38.2
unnamed: J6.7, R35.2
unnamed: J6.8, R36.2
unnamed: J7.2, R39.1, R42.2
unnamed: J8.2, R40.1, R44.2
unnamed: J10.2, R41.1, R43.2
unnamed: J3.6, J11.1
unnamed: J3.5, J11.3
unnamed: JP1.1, R1.1
unnamed: R27.2, U1.27
unnamed: R28.2, U1.26
unnamed: R33.1, U1.42
unnamed: R34.1, U1.34
unnamed: R35.1, U1.31
unnamed: R36.1, U1.30
unnamed: R37.1, U1.33
unnamed: R38.1, U1.32
unnamed: U1.22, Y1.3
unnamed: U1.23, Y1.1
PM0: C29.1, R40.2, U1.24
PM1: C28.1, R39.2, U1.25
SCK: J2.6, J9.4, R32.2
SCL: J3.2, J5.1
SDA: J3.1, J5.2
UA: D2.2, J4.1, R10.2
UB: D1.2, J4.2, R11.2
UC: D3.2, J4.3, R12.2
USB: D5.1, J3.10
