ArtemovSA/ILC_project/Info/python-on-a-chip-master/src/platform/pic24/include/pic24_uart.h

#define _PIC24_UART1_H_
#if (NUM_UART_MODS >= 1)
#define DEFAULT_BAUDRATE1  DEFAULT_BAUDRATE
#define DEFAULT_BRGH1  DEFAULT_BRGH
inline static void CONFIG_BAUDRATE_UART1(uint32 baudRate) {
#if (DEFAULT_BRGH1 == 0)
  float f_brg = (((float) FCY)/((float) baudRate)/16.0) - 1.0;
#else
  float f_brg = (((float) FCY)/((float) baudRate)/4.0) - 1.0;
#endif
  ASSERT(f_brg < 65535.5);
  U1MODEbits.BRGH = DEFAULT_BRGH1;
  U1BRG = roundFloatToUint16(f_brg);
}
#define UXMODE_PDSEL_8DATA_NOPARITY   0
#define UXMODE_PDSEL_8DATA_EVENPARITY 1
#define UXMODE_PDSEL_8DATA_ODDPARITY  2
#define UXMODE_PDSEL_9DATA_NOPARITY   3
inline static void CONFIG_PDSEL_UART1(uint8 u8_pdsel) {
  ASSERT(u8_pdsel <= UXMODE_PDSEL_9DATA_NOPARITY);
  U1MODEbits.PDSEL = u8_pdsel;
}
inline static void CONFIG_STOPBITS_UART1(uint8 u8_numStopbits) {
  ASSERT(u8_numStopbits <= 2);
  U1MODEbits.STSEL = u8_numStopbits - 1;
}
inline static void ENABLE_UART1() {
  U1MODEbits.UEN = 0b00;                    // UxTX and UxRX pins are enabled and used; no flow control pins
  U1MODEbits.UARTEN = 1;                    // enable UART RX/TX
  U1STAbits.UTXEN = 1;                      //Enable the transmitter
}
#define IS_CHAR_READY_UART1() U1STAbits.URXDA
#define IS_TRANSMIT_BUFFER_FULL_UART1() U1STAbits.UTXBF
#define IS_TRANSMIT_COMPLETE_UART1() U1STAbits.TRMT
inline static void WAIT_UNTIL_TRANSMIT_COMPLETE_UART1() {
  while (!IS_TRANSMIT_COMPLETE_UART1())
    doHeartbeat();
}
void outChar1(uint8 u8_c);
uint8 inChar1(void);
void configUART1(uint32 u32_baudRate);
uint8 isCharReady1(void);
void checkRxErrorUART1(void);  //check for UART RX error
#endif // #if (NUM_UART_MODS >= 1)
#define _PIC24_UART2_H_
#if (NUM_UART_MODS >= 2)
#define DEFAULT_BAUDRATE2  DEFAULT_BAUDRATE
#define DEFAULT_BRGH2  DEFAULT_BRGH
inline static void CONFIG_BAUDRATE_UART2(uint32 baudRate) {
#if (DEFAULT_BRGH2 == 0)
  float f_brg = (((float) FCY)/((float) baudRate)/16.0) - 1.0;
#else
  float f_brg = (((float) FCY)/((float) baudRate)/4.0) - 1.0;
#endif
  ASSERT(f_brg < 65535.5);
  U2MODEbits.BRGH = DEFAULT_BRGH2;
  U2BRG = roundFloatToUint16(f_brg);
}
#define UXMODE_PDSEL_8DATA_NOPARITY   0
#define UXMODE_PDSEL_8DATA_EVENPARITY 1
#define UXMODE_PDSEL_8DATA_ODDPARITY  2
#define UXMODE_PDSEL_9DATA_NOPARITY   3
inline static void CONFIG_PDSEL_UART2(uint8 u8_pdsel) {
  ASSERT(u8_pdsel <= UXMODE_PDSEL_9DATA_NOPARITY);
  U2MODEbits.PDSEL = u8_pdsel;
}
inline static void CONFIG_STOPBITS_UART2(uint8 u8_numStopbits) {
  ASSERT(u8_numStopbits <= 2);
  U2MODEbits.STSEL = u8_numStopbits - 1;
}
inline static void ENABLE_UART2() {
  U2MODEbits.UEN = 0b00;                    // UxTX and UxRX pins are enabled and used; no flow control pins
  U2MODEbits.UARTEN = 1;                    // enable UART RX/TX
  U2STAbits.UTXEN = 1;                      //Enable the transmitter
}
#define IS_CHAR_READY_UART2() U2STAbits.URXDA
#define IS_TRANSMIT_BUFFER_FULL_UART2() U2STAbits.UTXBF
#define IS_TRANSMIT_COMPLETE_UART2() U2STAbits.TRMT
inline static void WAIT_UNTIL_TRANSMIT_COMPLETE_UART2() {
  while (!IS_TRANSMIT_COMPLETE_UART2())
    doHeartbeat();
}
void outChar2(uint8 u8_c);
uint8 inChar2(void);
void configUART2(uint32 u32_baudRate);
uint8 isCharReady2(void);
void checkRxErrorUART2(void);  //check for UART RX error
#endif // #if (NUM_UART_MODS >= 2)
#define _PIC24_UART3_H_
#if (NUM_UART_MODS >= 3)
#define DEFAULT_BAUDRATE3  DEFAULT_BAUDRATE
#define DEFAULT_BRGH3  DEFAULT_BRGH
inline static void CONFIG_BAUDRATE_UART3(uint32 baudRate) {
#if (DEFAULT_BRGH3 == 0)
  float f_brg = (((float) FCY)/((float) baudRate)/16.0) - 1.0;
#else
  float f_brg = (((float) FCY)/((float) baudRate)/4.0) - 1.0;
#endif
  ASSERT(f_brg < 65535.5);
  U3MODEbits.BRGH = DEFAULT_BRGH3;
  U3BRG = roundFloatToUint16(f_brg);
}
#define UXMODE_PDSEL_8DATA_NOPARITY   0
#define UXMODE_PDSEL_8DATA_EVENPARITY 1
#define UXMODE_PDSEL_8DATA_ODDPARITY  2
#define UXMODE_PDSEL_9DATA_NOPARITY   3
inline static void CONFIG_PDSEL_UART3(uint8 u8_pdsel) {
  ASSERT(u8_pdsel <= UXMODE_PDSEL_9DATA_NOPARITY);
  U3MODEbits.PDSEL = u8_pdsel;
}
inline static void CONFIG_STOPBITS_UART3(uint8 u8_numStopbits) {
  ASSERT(u8_numStopbits <= 2);
  U3MODEbits.STSEL = u8_numStopbits - 1;
}
inline static void ENABLE_UART3() {
  U3MODEbits.UEN = 0b00;                    // UxTX and UxRX pins are enabled and used; no flow control pins
  U3MODEbits.UARTEN = 1;                    // enable UART RX/TX
  U3STAbits.UTXEN = 1;                      //Enable the transmitter
}
#define IS_CHAR_READY_UART3() U3STAbits.URXDA
#define IS_TRANSMIT_BUFFER_FULL_UART3() U3STAbits.UTXBF
#define IS_TRANSMIT_COMPLETE_UART3() U3STAbits.TRMT
inline static void WAIT_UNTIL_TRANSMIT_COMPLETE_UART3() {
  while (!IS_TRANSMIT_COMPLETE_UART3())
    doHeartbeat();
}
void outChar3(uint8 u8_c);
uint8 inChar3(void);
void configUART3(uint32 u32_baudRate);
uint8 isCharReady3(void);
void checkRxErrorUART3(void);  //check for UART RX error
#endif // #if (NUM_UART_MODS >= 3)
#define _PIC24_UART4_H_
#if (NUM_UART_MODS >= 4)
#define DEFAULT_BAUDRATE4  DEFAULT_BAUDRATE
#define DEFAULT_BRGH4  DEFAULT_BRGH
inline static void CONFIG_BAUDRATE_UART4(uint32 baudRate) {
#if (DEFAULT_BRGH4 == 0)
  float f_brg = (((float) FCY)/((float) baudRate)/16.0) - 1.0;
#else
  float f_brg = (((float) FCY)/((float) baudRate)/4.0) - 1.0;
#endif
  ASSERT(f_brg < 65535.5);
  U4MODEbits.BRGH = DEFAULT_BRGH4;
  U4BRG = roundFloatToUint16(f_brg);
}
#define UXMODE_PDSEL_8DATA_NOPARITY   0
#define UXMODE_PDSEL_8DATA_EVENPARITY 1
#define UXMODE_PDSEL_8DATA_ODDPARITY  2
#define UXMODE_PDSEL_9DATA_NOPARITY   3
inline static void CONFIG_PDSEL_UART4(uint8 u8_pdsel) {
  ASSERT(u8_pdsel <= UXMODE_PDSEL_9DATA_NOPARITY);
  U4MODEbits.PDSEL = u8_pdsel;
}
inline static void CONFIG_STOPBITS_UART4(uint8 u8_numStopbits) {
  ASSERT(u8_numStopbits <= 2);
  U4MODEbits.STSEL = u8_numStopbits - 1;
}
inline static void ENABLE_UART4() {
  U4MODEbits.UEN = 0b00;                    // UxTX and UxRX pins are enabled and used; no flow control pins
  U4MODEbits.UARTEN = 1;                    // enable UART RX/TX
  U4STAbits.UTXEN = 1;                      //Enable the transmitter
}
#define IS_CHAR_READY_UART4() U4STAbits.URXDA
#define IS_TRANSMIT_BUFFER_FULL_UART4() U4STAbits.UTXBF
#define IS_TRANSMIT_COMPLETE_UART4() U4STAbits.TRMT
inline static void WAIT_UNTIL_TRANSMIT_COMPLETE_UART4() {
  while (!IS_TRANSMIT_COMPLETE_UART4())
    doHeartbeat();
}
void outChar4(uint8 u8_c);
uint8 inChar4(void);
void configUART4(uint32 u32_baudRate);
uint8 isCharReady4(void);
void checkRxErrorUART4(void);  //check for UART RX error
#endif // #if (NUM_UART_MODS >= 4)
