ArtemovSA/ILC_project/Src/main.c

/* Includes ------------------------------------------------------------------*/
#include "main.h"
#include "stm32f4xx_hal.h"
#include "cmsis_os.h"
#include "fatfs.h"
#include "lwip.h"
#include "usb_device.h"

/* USER CODE BEGIN Includes */
#include "devMQTT.h"
#include "DevCTRL.h"
#include "usbd_cdc_if.h"
#include "PCA9555.h"
#include "V9203.h"
#include "Clock.h"
#include "dns.h"
#include "EMS_protocol.h"
#include "FW_update.h"
#include "TASK_script.h"
#include "USB_port.h"
#include "USB_ctrl.h"

/* USER CODE END Includes */

SD_HandleTypeDef hsd;
DMA_HandleTypeDef hdma_sdio_rx;
DMA_HandleTypeDef hdma_sdio_tx;

ADC_HandleTypeDef hadc3;

CRC_HandleTypeDef hcrc;

I2C_HandleTypeDef hi2c1;
I2C_HandleTypeDef hi2c2;

RTC_HandleTypeDef hrtc;

IWDG_HandleTypeDef hiwdg;

SD_HandleTypeDef hsd;

SPI_HandleTypeDef hspi1;

UART_HandleTypeDef huart1;
UART_HandleTypeDef huart3;
UART_HandleTypeDef huart6;

SRAM_HandleTypeDef hsram1;
SRAM_HandleTypeDef hsram2;
NAND_HandleTypeDef hnand1;

osThreadId debugTaskHandle;
osTimerId SampleTimerHandle;

osMessageQId debug_TTqueueHandle;
osMessageQId EMS_TTqueueHandle;
osMessageQId Modem_TTqueueHandle;

/* USER CODE BEGIN PV */

/* USER CODE END PV */

void SystemClock_Config(void);
static void MX_GPIO_Init(void);
static void MX_DMA_Init(void);
static void MX_ADC3_Init(void);
static void MX_FSMC_Init(void);
static void MX_I2C1_Init(void);
static void MX_I2C2_Init(void);
static void MX_SDIO_SD_Init(void);
static void MX_SPI1_Init(void);
static void MX_USART1_UART_Init(void);
static void MX_USART3_UART_Init(void);
static void MX_USART6_UART_Init(void);
static void MX_CRC_Init(void);
static void MX_RTC_Init(void);
static void MX_IWDG_Init(void);
void startDebugTask(void const * argument);
void sampleTimerCall(void const * argument);

/* USER CODE BEGIN PFP */

/* USER CODE END PFP */

/* USER CODE BEGIN 0 */

SemaphoreHandle_t muxNAND;
SemaphoreHandle_t muxSRAM1;
SemaphoreHandle_t muxSRAM2;
SemaphoreHandle_t muxUSB;
SemaphoreHandle_t muxV9203;
SemaphoreHandle_t muxData;
SemaphoreHandle_t muxSD;

/* USER CODE END 0 */


/**
  * @brief  The application entry point.
  *
  * @retval None
  */
 int main(void)
{
  /* USER CODE BEGIN 1 */

  SCB->VTOR = FW_IMAGE_START_ADDRESS;
  
  /* USER CODE END 1 */

  /* MCU Configuration----------------------------------------------------------*/

  /* Reset of all peripherals, Initializes the Flash interface and the Systick. */
  HAL_Init();

  /* Configure the system clock */
  SystemClock_Config();

  /* Initialize all configured peripherals */
  MX_GPIO_Init();
  MX_DMA_Init();
  MX_ADC3_Init();
  MX_FSMC_Init();
  MX_I2C1_Init();
  MX_I2C2_Init();
  MX_SDIO_SD_Init();
  MX_SPI1_Init();
  MX_USART1_UART_Init();
  MX_USART3_UART_Init();
  MX_USART6_UART_Init();
  MX_CRC_Init();
  MX_RTC_Init();
  MX_IWDG_Init();
  /* USER CODE BEGIN 2 */

  __enable_irq();

  /* USER CODE END 2 */

  /* USER CODE BEGIN RTOS_MUTEX */
  muxNAND = xSemaphoreCreateMutex();
  muxSRAM1 = xSemaphoreCreateMutex();
  muxSRAM2 = xSemaphoreCreateMutex();
  muxUSB = xSemaphoreCreateMutex();
  muxV9203 = xSemaphoreCreateMutex();
  muxData = xSemaphoreCreateMutex();
  muxSD = xSemaphoreCreateMutex();

  /* Create the timer(s) */
  osTimerDef(SampleTimer, sampleTimerCall);
  SampleTimerHandle = osTimerCreate(osTimer(SampleTimer), osTimerPeriodic, NULL);

  /* definition and creation of debugTask */
  osThreadDef(debugTask, startDebugTask, osPriorityNormal, 0, 256);
  debugTaskHandle = osThreadCreate(osThread(debugTask), NULL);

  /* Create the queue(s) */
  osMessageQDef(debug_TTqueue, 5, uint16_t);
  debug_TTqueueHandle = osMessageCreate(osMessageQ(debug_TTqueue), NULL);

  osMessageQDef(EMS_TTqueue, 5, uint16_t);
  EMS_TTqueueHandle = osMessageCreate(osMessageQ(EMS_TTqueue), NULL);
  
  osMessageQDef(Modem_TTqueue, 5, uint16_t);
  Modem_TTqueueHandle = osMessageCreate(osMessageQ(Modem_TTqueue), NULL);

  /* Start scheduler */
  osKernelStart();

  while (1)
  {

  }
}

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
/* USER CODE BEGIN 4 */

  FRESULT FATF_res;
  FATFS FATF_Obj;
  FIL fileDebug;
  
/* USER CODE END 4 */

/* startDebugTask function */
void startDebugTask(void const * argument)
{  
  /* init code for USB_DEVICE */
  MX_USB_DEVICE_Init();
  
  /* init code for FATFS */
  MX_FATFS_Init();
 
   /* USER CODE BEGIN 5 */
  DC_init(&debug_TTqueueHandle);   

  V9203_init(&hspi1, &DC_set.EMS_channelEn, &DC_state.V9203_channelsActive, DC_calibr.channel_cal);

  /* init code for LWIP */
  MX_LWIP_Init(DC_set.net_dev_ip_addr, DC_set.net_mask, DC_set.net_gw_ip_addr, DC_set.net_DHCP_en);

  if (DC_set.net_DHCP_en == 1)
  {
    vTaskDelay(1000);
    
    uint8_t ip[4];
    if (MX_LWIP_getIP(ip))
    {
      DC_debug_ipAdrrOut("# DHCP enable, IP: ", ip);
    }
  }else{
    DC_debug_ipAdrrOut("# Static IP: ", DC_set.net_dev_ip_addr);
  }
  
  //Set led status
  stateState = LED_PROC_OK;

  //USB
  USBP_init();
  USBC_init(osPriorityNormal);
  
  //DNS init
  ip4_addr_t ipaddr;
  IP4_ADDR(&ipaddr, DC_set.serverDNS[0], DC_set.serverDNS[1], DC_set.serverDNS[2], DC_set.serverDNS[3]);
  dns_setserver(0, &ipaddr);
  dns_init();
  DC_debugOut("# DNS init OK\r\n");
  
  CL_init(); //Init clock

  USBP_mode = USBP_MODE_CMD;

  //Start sample timer
  osTimerStart(SampleTimerHandle, 1000);
  
  //Init EMS
  EMS_init();

  //Инициализация задачи
  TASK_script_init(0);

  /* USER CODE BEGIN 5 */
  /* Infinite loop */
  for(;;)
  {
    osDelay(1000);
  }
  
  /* USER CODE END 5 */ 
}


/* sampleTimerCall function */
void sampleTimerCall(void const * argument)
{
  dns_tmr();
  
  MX_link_sample(); //Link sample function  
  
  if (DC_state.statFlags.ethLink == 1)
  linkState = LED_PROC_OK;
    else
  linkState = LED_PROC_ERROR;
  
  //Reload watchDog
  DC_reloadDog();
}

/**
  * @brief  Period elapsed callback in non blocking mode
  * @note   This function is called  when TIM1 interrupt took place, inside
  * HAL_TIM_IRQHandler(). It makes a direct call to HAL_IncTick() to increment
  * a global variable "uwTick" used as application time base.
  * @param  htim : TIM handle
  * @retval None
  */
void HAL_TIM_PeriodElapsedCallback(TIM_HandleTypeDef *htim)
{
  if (htim->Instance == TIM1) {
    HAL_IncTick();
  }
}

/**
  * @brief  This function is executed in case of error occurrence.
  * @param  file: The file name as string.
  * @param  line: The line in file as a number.
  * @retval None
  */
void _Error_Handler(char *file, int line)
{
  /* USER CODE BEGIN Error_Handler_Debug */
  /* User can add his own implementation to report the HAL error return state */
  while(1)
  {
  }
  /* USER CODE END Error_Handler_Debug */
}

#ifdef  USE_FULL_ASSERT
/**
  * @brief  Reports the name of the source file and the source line number
  *         where the assert_param error has occurred.
  * @param  file: pointer to the source file name
  * @param  line: assert_param error line source number
  * @retval None
  */
void assert_failed(uint8_t* file, uint32_t line)
{ 
  /* USER CODE BEGIN 6 */
  /* User can add his own implementation to report the file name and line number,
     tex: printf("Wrong parameters value: file %s on line %d\r\n", file, line) */
  /* USER CODE END 6 */
}
#endif /* USE_FULL_ASSERT */

/**
  * @}
  */

/**
  * @}
  */

/************************ (C) COPYRIGHT STMicroelectronics *****END OF FILE****/
