ArtemovSA/ILC_project/Inc/main.h

#define nPW_INT_Pin GPIO_PIN_6
#define nPW_INT_GPIO_Port GPIOE
#define PW_CS_Pin GPIO_PIN_15
#define PW_CS_GPIO_Port GPIOA
#define ADC_VBAT_Pin GPIO_PIN_6
#define ADC_VBAT_GPIO_Port GPIOF
#define ADC_DET5V_Pin GPIO_PIN_7
#define ADC_DET5V_GPIO_Port GPIOF
#define RF_WDET1_Pin GPIO_PIN_8
#define RF_WDET1_GPIO_Port GPIOF
#define RF_WDET2_Pin GPIO_PIN_9
#define RF_WDET2_GPIO_Port GPIOF
#define RF_PF10_Pin GPIO_PIN_10
#define RF_PF10_GPIO_Port GPIOF
#define RF_PC0_Pin GPIO_PIN_0
#define RF_PC0_GPIO_Port GPIOC
#define nETH_INT_Pin GPIO_PIN_5
#define nETH_INT_GPIO_Port GPIOA
#define nETH_RES_Pin GPIO_PIN_6
#define nETH_RES_GPIO_Port GPIOA
#define GHARGE_STAT_Pin GPIO_PIN_0
#define GHARGE_STAT_GPIO_Port GPIOB
#define RF_PE11_Pin GPIO_PIN_11
#define RF_PE11_GPIO_Port GPIOE
#define RF_PE12_Pin GPIO_PIN_12
#define RF_PE12_GPIO_Port GPIOE
#define LED1_Pin GPIO_PIN_13
#define LED1_GPIO_Port GPIOE
#define LED2_Pin GPIO_PIN_14
#define LED2_GPIO_Port GPIOE
#define LED3_Pin GPIO_PIN_15
#define LED3_GPIO_Port GPIOE
#define SRAM_CE2_1_Pin GPIO_PIN_6
#define SRAM_CE2_1_GPIO_Port GPIOG
#define SRAM_CE2_2_Pin GPIO_PIN_7
#define SRAM_CE2_2_GPIO_Port GPIOG
