ArtemovSA/ILC_project/Info/python-on-a-chip-master/src/platform/pic24/include/pic24_libconfig.h

/*
 * "Copyright (c) 2008 Robert B. Reese, Bryan A. Jones, J. W. Bruce ("AUTHORS")"
 * All rights reserved.
 * (R. Reese, reese_AT_ece.msstate.edu, Mississippi State University)
 * (B. A. Jones, bjones_AT_ece.msstate.edu, Mississippi State University)
 * (J. W. Bruce, jwbruce_AT_ece.msstate.edu, Mississippi State University)
 *
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
 * IN NO EVENT SHALL THE "AUTHORS" BE LIABLE TO ANY PARTY FOR
 * DIRECT, INDIRECT, SPECIAL, INCIDENTAL, OR CONSEQUENTIAL DAMAGES ARISING OUT
 * OF THE USE OF THIS SOFTWARE AND ITS DOCUMENTATION, EVEN IF THE "AUTHORS"
 * HAS BEEN ADVISED OF THE POSSIBILITY OF SUCH DAMAGE.
 *
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
 * Please maintain this header in its entirety when copying/modifying
 * these files.
 *
 *
 */

// Documentation for this file. If the \file tag isn't present,
// this file won't be documented.
/** \file
 *  This file consolidates all the user-configurable \#defines
 *  scattered throughout the \ref PIC24_support
 *  "PIC24 support library". These may be changed by either
 *  editing the files in which these \#defines occur,
 *  copying then editing the \#defines below to a position below this comment
 *  (which overrides values
 *  set by the previous method), or by defining them via passing
 *  a <code>-Dname=value</code> flag to the compiler.
 */

// No relevant defines in pic24_adc.h

/** @{
 *  \name Defines from pic24_clockfreq.h
 */

// Doxygen 1.5.6 warns that the \copydoc below produces a
// recursive call chain. This warning also appears if
// the referenced file doesn't exist, so it seems like
// Doxygen can find the referenced file. Workaround: this
// file needs to come before all of its references
// alphabetically (i.e. pic24_alibconfig.h puts it before
// pic24_clockfreq.h, which makes the line below work).
/// \copysee{pic24_clockfreq.h::CLOCK_CONFIG}
// Uncomment one of the #defines below to make
// a clock choice. If all the #defines below
// are commentend, code in pic24_clockfreq.h
// will pick a default clock choice.
#ifndef CLOCK_CONFIG
//#define CLOCK_CONFIG SIM_CLOCK
//#define CLOCK_CONFIG FRCPLL_FCY16MHz
//#define CLOCK_CONFIG FRC_FCY4MHz
//#define CLOCK_CONFIG PRIPLL_8MHzCrystal_16MHzFCY
//#define CLOCK_CONFIG PRI_NO_PLL_7372KHzCrystal
//#define CLOCK_CONFIG FRC_FCY3685KHz
//#define CLOCK_CONFIG FRCPLL_FCY40MHz
//#define CLOCK_CONFIG PRIPLL_7372KHzCrystal_40MHzFCY
//#define CLOCK_CONFIG PRIPLL_8MHzCrystal_40MHzFCY
#endif

// For convenience, choose the fastest
// possible clock depending on which
// processor we're using. If simulation mode is
// selected, then use the simulation clock.
#ifndef CLOCK_CONFIG
#if defined(SIM)
#define CLOCK_CONFIG SIM_CLOCK
#elif defined(EXPLORER16_100P) && defined(__PIC24H__)
#define CLOCK_CONFIG PRIPLL_8MHzCrystal_40MHzFCY
#elif defined(EXPLORER16_100P) && defined(__PIC24F__)
#define CLOCK_CONFIG PRIPLL_8MHzCrystal_16MHzFCY
#elif defined(__PIC24H__) || defined(__DOXYGEN__)
#define CLOCK_CONFIG FRCPLL_FCY40MHz
#elif defined(__PIC24F__)  || defined(__PIC24FK__)
#define CLOCK_CONFIG FRCPLL_FCY16MHz
#elif defined(__dsPIC33F__)
#define CLOCK_CONFIG FRCPLL_FCY40MHz
#else
#error Unknown processor
#endif
#endif

/// @}

/** \name Defines from pic24_delay.h
 *  @{
 */

// Renaming this from pic24_defaults.h to pic24_libconfig.h
// causes this to be reported by Doxygen as a recursive call
// chain. Doxygen 1.5.6. See comments on CLOCK_CONFIG in this
// file for a workaround.
/// \copysee{pic24_delay.h::DEBOUNCE_DLY}
#ifndef DEBOUNCE_DLY
#define DEBOUNCE_DLY  15   //in milliseconds
#endif

/// @}


// No relevant defines in pic24_dma.h
// No relevant defines in pic24_ecan.h
// No relevant defines in pic24_flash.h
// No relevant defines in pic24_generic.h
// No relevant defines in pic24_i2c.h
// No relevant defines in pic24_ports.h

/** \name Defines from pic24_serial.h
 *  @{
 */

/// \copysee{pic24_serial.h::SERIAL_EOL_DEFAULT}
#ifndef SERIAL_EOL_DEFAULT   //can be overridden in project file
#define SERIAL_EOL_DEFAULT SERIAL_EOL_LF
#endif

/// \copysee{pic24_serial.h::DEFAULT_UART}
#ifndef DEFAULT_UART
#if defined(EXPLORER16_100P)
#define DEFAULT_UART 2
#else
#define DEFAULT_UART 1
#endif
#endif

/// @}

// No relevant defines in pic24_spi.h
// No relevant defines in pic24_timer.h

/** \name Defines configuring pic24_uart.h operation
 *  @{
 */

/** Default baud rate used by \ref configBasic() to
 * configure the \ref DEFAULT_UART.
 */
#ifndef DEFAULT_BAUDRATE
// For convenience, common baud rates (uncomment one):
#define DEFAULT_BAUDRATE  230400
//#define DEFAULT_BAUDRATE  115200
//#define DEFAULT_BAUDRATE   57600
//#define DEFAULT_BAUDRATE   38400
//#define DEFAULT_BAUDRATE   19200
//#define DEFAULT_BAUDRATE    9600
#endif

/** Default BRGH value used by \ref CONFIG_BAUDRATE_UART1 to 4
 *  when configurating a UART. This value may be
 *  overridden on a per-UART basis by \#defineing
 *  \ref DEFAULT_BRGH1 to 4. Allowed values:
 *  - BRGH = 0 - the baud rate divisor is 16
 *  - BRGH = 1 - the baud rate divisor is 4
 */
#ifndef DEFAULT_BRGH
#define DEFAULT_BRGH  0
#endif

#if (DEFAULT_BRGH != 0) && (DEFAULT_BRGH != 1)
#error Invalid value for DEFAULT_BRGH
#endif

/// @}

// No relevant defines in pic24_timer.h

/** \name Defines from pic24_util.h
 *  @{
 */

#ifndef USE_CLOCK_TIMEOUT
  #ifdef BUILT_ON_ESOS
    #define USE_CLOCK_TIMEOUT 0
  #else
    #define USE_CLOCK_TIMEOUT 1
  #endif
#endif

#ifndef USE_HEARTBEAT
  /// \copysee{pic24_util.h::USE_HEARTBEAT}
  #define USE_HEARTBEAT 1
#endif



#ifndef HB_LED
  #if defined(EXPLORER16_100P)
    #define HB_LED _LATA7
    #define CONFIG_HB_LED() CONFIG_RA7_AS_DIG_OUTPUT()
  #elif defined(DANGEROUS_WEB)
    #define HB_LED _LATA8
    /** Define a config function for the heartbeat pin. */
    #define CONFIG_HB_LED() CONFIG_RA8_AS_DIG_OUTPUT()
  #elif defined(MICROSTIK)
    #define HB_LED _LATB15
    #define CONFIG_HB_LED() CONFIG_RB15_AS_DIG_OUTPUT()
  #else
    /// \copysee{pic24_uart.h::HB_LED}
    #define HB_LED _LATB15
    /// \copysee{pic24_uart.h::CONFIG_HB_LED}
    #define CONFIG_HB_LED() CONFIG_RB15_AS_DIG_OD_OUTPUT()
  #endif
#endif // #ifndef HB_LED

/// @}
