ArtemovSA/ILC_project/Info/python-on-a-chip-master/src/platform/arduino_mega/main.c

/*
# This file is Copyright 2007, 2009 Dean Hall.
#
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
# Python-on-a-Chip is distributed in the hope that it will be useful,
# but WITHOUT ANY WARRANTY; without even the implied warranty of
# MERCHANTABILITY or FITNESS FOR A PARTICULAR PURPOSE.
# A copy of the GNU LESSER GENERAL PUBLIC LICENSE Version 2.1
# is seen in the file COPYING up one directory from this.
*/

/** Sample PyMite application */


#include "pm.h"

#define HEAP_SIZE 0x1D00


extern unsigned char usrlib_img[];


int main(void)
{
    uint8_t heap[HEAP_SIZE];
    PmReturn_t retval;

    retval = pm_init(heap, HEAP_SIZE, MEMSPACE_PROG, usrlib_img);
    PM_RETURN_IF_ERROR(retval);

    retval = pm_run((uint8_t *)"main");
    return (int)retval;
}
