ArtemovSA/ILC_project/Info/python-on-a-chip-master/src/platform/econotag/main.py

#
# PyMite - A flyweight Python interpreter for 8-bit and larger microcontrollers.
# Copyright 2002 Dean Hall.  All rights reserved.
# PyMite is offered through one of two licenses: commercial or open-source.
# See the LICENSE file at the root of this package for licensing details.
#

import ipm
ipm.ipm()
