ArtemovSA/ILC_project/(commit log)

2018-05-17 Make repo
    [First_Sheet.SCHDOC, IOT_CPU_v0.PcbDoc, IOT_CPU_v0.PrjPcb, IOT_CPU_v0.pcb, IOT_CPU_v0.sch, IOT_GSM3G_v0.pcb, IOT_GSM3G_v0.sch, IOT_IO_v0.PcbDoc]
2018-06-10 Voltage add
    [Featherwing.sch, V9203.sch, V9203_Devkit.kicad_pcb, V9203_Devkit.sch, file58CFD8CB.sch]
2018-06-11 MQTT start
    [Featherwing.sch, First_Sheet.SCHDOC, IOT_CPU_v0.PcbDoc, IOT_CPU_v0.PrjPcb, IOT_CPU_v0.pcb, IOT_CPU_v0.sch, IOT_GSM3G_v0.pcb, IOT_GSM3G_v0.sch]
2018-06-20 Power metering
    [Featherwing.sch, V9203.sch, V9203_Devkit.kicad_pcb, V9203_Devkit.sch, file58CFD8CB.sch]
2018-06-20 Revert "Power metering"
    This reverts commit feb86d65deffb48ed740df54479fd7a505506fc5.
    [Featherwing.sch, V9203.sch, V9203_Devkit.kicad_pcb, V9203_Devkit.sch, file58CFD8CB.sch]
2018-06-27 Calibration OK
2018-07-08 First version
    [Speed test.xlsx]
2018-09-27 Revert "log debug"
    This reverts commit 14ddd8da34bbbe841a4c191511d9d65249bf95d9.
    [Bootloader.ioc, ILC.ioc, ffconf.h]
2018-10-17 Fix bags
    Fix connection
    Fix link
    Fix trabsmit
    [main.c]
