ArtemovSA/ILC_project/(notices)

Notices in the files:
Info/python-on-a-chip-master/src/platform/mbed/mbed.py:
Python-on-a-Chip is free software: you can redistribute it and/or modify
it under the terms of the GNU LESSER GENERAL PUBLIC LICENSE Version 2.1.
